Voltworks-Garage/Hardware/README.md

# Hardware
Hardware repo for all PCBA design
