Voltworks-Garage/Hardware/PCBAs/BMS/DischargeCircuit.PNG

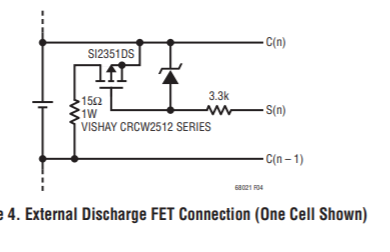
PCBAs/BMS/DischargeCircuit.PNG
