Voltworks-Garage/Hardware/PCBAs/BMS/DischargeCircuit_wRC.PNG

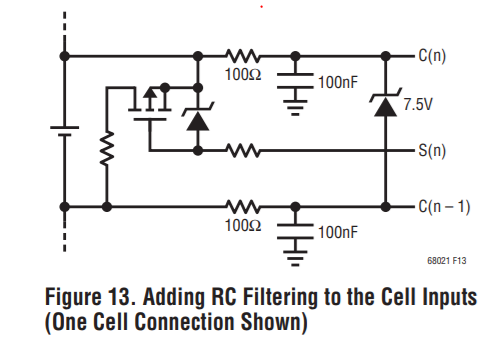
PCBAs/BMS/DischargeCircuit_wRC.PNG
