Voltworks-Garage/Hardware/PCBAs/DCDC/Isolated Gate Drive.PNG

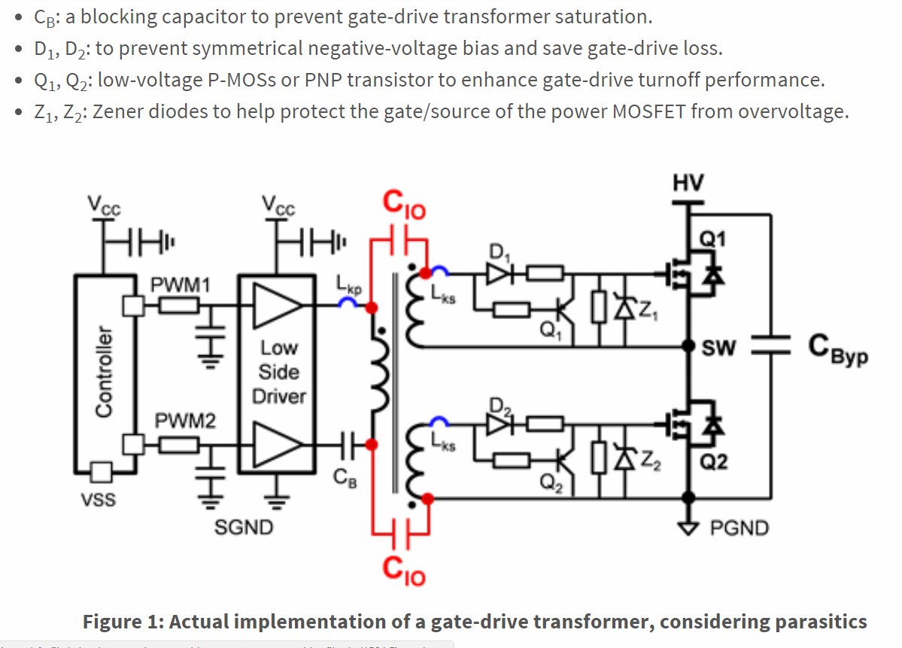
PCBAs/DCDC/Isolated Gate Drive.PNG
