Voltworks-Garage/Hardware/PCBAs/BMS/BMS_02/BOM_by_refdes.xls

RefDes | Value | Digikey_PN | Mouser_PN | MFG_PN | Footprint | Alternate | DNP | Voltage | qty
C1 | 100nF | 490-4779-1-ND |  | GCM188R71H104KA57D | Capacitor_SMD:C_0603_1608Metric |  |  | 50V | 1
C2 | 100nF | 490-4779-1-ND |  | GCM188R71H104KA57D | Capacitor_SMD:C_0603_1608Metric |  |  | 50V | 1
C3 | 100nF | 490-4779-1-ND |  | GCM188R71H104KA57D | Capacitor_SMD:C_0603_1608Metric |  |  | 50V | 1
C4 | 100nF | 490-4779-1-ND |  | GCM188R71H104KA57D | Capacitor_SMD:C_0603_1608Metric |  |  | 50V | 1
C5 | 100nF | 490-4779-1-ND |  | GCM188R71H104KA57D | Capacitor_SMD:C_0603_1608Metric |  |  | 50V | 1
C6 | 100nF | 490-4779-1-ND |  | GCM188R71H104KA57D | Capacitor_SMD:C_0603_1608Metric |  |  | 50V | 1
C7 | 100nF | 490-4779-1-ND |  | GCM188R71H104KA57D | Capacitor_SMD:C_0603_1608Metric |  |  | 50V | 1
C9 | 100nF | 490-4779-1-ND |  | GCM188R71H104KA57D | Capacitor_SMD:C_0603_1608Metric |  |  | 50V | 1
C10 | 18pF | 445-5631-1-ND |  | CGA3E2C0G1H180J080AA | Capacitor_SMD:C_0603_1608Metric |  |  | 50V | 1
C11 | 18pF | 445-5631-1-ND |  | CGA3E2C0G1H180J080AA | Capacitor_SMD:C_0603_1608Metric |  |  | 50V | 1
C14 | 100nF | 490-4779-1-ND |  | GCM188R71H104KA57D | Capacitor_SMD:C_0603_1608Metric |  |  |  | 1
C18 | 100nF | 490-4779-1-ND |  | GCM188R71H104KA57D | Capacitor_SMD:C_0603_1608Metric |  |  |  | 1
C19 | 100nF | 490-4779-1-ND |  | GCM188R71H104KA57D | Capacitor_SMD:C_0603_1608Metric |  |  |  | 1
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
C164 | 100nF | 490-4779-1-ND |  | GCM188R71H104KA57D | Capacitor_SMD:C_0603_1608Metric |  |  |  | 1
C165 | 100nF | 490-4779-1-ND |  | GCM188R71H104KA57D | Capacitor_SMD:C_0603_1608Metric |  |  |  | 1
C166 | 100nF | 490-4779-1-ND |  | GCM188R71H104KA57D | Capacitor_SMD:C_0603_1608Metric |  |  |  | 1
C167 | 100nF | 490-4779-1-ND |  | GCM188R71H104KA57D | Capacitor_SMD:C_0603_1608Metric |  |  |  | 1
C168 | 100nF | 490-4779-1-ND |  | GCM188R71H104KA57D | Capacitor_SMD:C_0603_1608Metric |  |  |  | 1
C169 | 100nF | 490-4779-1-ND |  | GCM188R71H104KA57D | Capacitor_SMD:C_0603_1608Metric |  |  |  | 1
C170 | 100nF | 490-4779-1-ND |  | GCM188R71H104KA57D | Capacitor_SMD:C_0603_1608Metric |  |  |  | 1
C171 | 100nF | 490-4779-1-ND |  | GCM188R71H104KA57D | Capacitor_SMD:C_0603_1608Metric |  |  |  | 1
C172 | 10nF | 490-4781-1-ND |  | GCM188R72A103KA37D | Capacitor_SMD:C_0603_1608Metric |  |  |  | 1
C173 | 10nF | 490-4781-1-ND |  | GCM188R72A103KA37D | Capacitor_SMD:C_0603_1608Metric |  |  |  | 1
C174 | 10nF | 490-4781-1-ND |  | GCM188R72A103KA37D | Capacitor_SMD:C_0603_1608Metric |  |  |  | 1
C175 | 10nF | 490-4781-1-ND |  | GCM188R72A103KA37D | Capacitor_SMD:C_0603_1608Metric |  |  |  | 1
C176 | 10nF | 490-4781-1-ND |  | GCM188R72A103KA37D | Capacitor_SMD:C_0603_1608Metric |  |  |  | 1
C178 | 10nF | 490-4781-1-ND |  | GCM188R72A103KA37D | Capacitor_SMD:C_0603_1608Metric |  |  |  | 1
C8 | 10uF | 1276-6797-1-ND |  | CL31B106KOHVPNE | Capacitor_SMD:C_1206_3216Metric |  |  | 50V | 1
C12 | 100nF | 445-5851-1-ND |  | CGA5L3X7R2E104K160AA | Capacitor_SMD:C_1206_3216Metric |  |  |  | 1
C13 | 100nF | 445-5851-1-ND |  | CGA5L3X7R2E104K160AA | Capacitor_SMD:C_1206_3216Metric |  |  |  | 1
C15 | 100nF | 445-5851-1-ND |  | CGA5L3X7R2E104K160AA | Capacitor_SMD:C_1206_3216Metric |  |  |  | 1
C16 | 100nF | 445-5851-1-ND |  | CGA5L3X7R2E104K160AA | Capacitor_SMD:C_1206_3216Metric |  |  |  | 1
C17 | 100nF | 445-5851-1-ND |  | CGA5L3X7R2E104K160AA | Capacitor_SMD:C_1206_3216Metric |  |  |  | 1
C22 | 10uF | 1276-6797-1-ND |  | CL31B106KOHVPNE | Capacitor_SMD:C_1206_3216Metric |  |  |  | 1
C23 | 10uF | 1276-6797-1-ND |  | CL31B106KOHVPNE | Capacitor_SMD:C_1206_3216Metric |  |  |  | 1
C26 | 100nF | 445-5851-1-ND |  | CGA5L3X7R2E104K160AA | Capacitor_SMD:C_1206_3216Metric |  |  |  | 1
C43 | 100nF | 445-5851-1-ND |  | CGA5L3X7R2E104K160AA | Capacitor_SMD:C_1206_3216Metric |  |  |  | 1
C62 | 4u7 | 445-172481-1-ND |  | CGA5L3X7R1H475K160AE | Capacitor_SMD:C_1206_3216Metric |  |  |  | 1
C66 | 4u7 | 445-172481-1-ND |  | CGA5L3X7R1H475K160AE | Capacitor_SMD:C_1206_3216Metric |  |  |  | 1
C105 | 10uF | 1276-6797-1-ND |  | CL31B106KOHVPNE | Capacitor_SMD:C_1206_3216Metric |  |  |  | 1
C177 | 4u7 | 445-172481-1-ND |  | CGA5L3X7R1H475K160AE | Capacitor_SMD:C_1206_3216Metric |  |  |  | 1
C118 | 1u | 445-4532-1-ND |  |  | Capacitor_SMD:C_2220_5650Metric |  |  |  | 1
C122 | 1u | 445-4532-1-ND |  |  | Capacitor_SMD:C_2220_5650Metric |  |  |  | 1
C133 | 47u | 1189-16SLV47M6.3X6.1CT-ND |  |  | Capacitor_SMD:CP_Elec_6.3x5.9 |  |  |  | 1
C117 | 22u | 493-14364-ND |  |  | Capacitor_THT:CP_Radial_D10.0mm_P5.00mm |  |  |  | 1
J12 | Conn_01x02 |  |  |  | Connector_JST:JST_XH_B2B-XH-A_1x02_P2.50mm_Vertical |  |  |  | 1
J15 | Conn_01x02 |  |  |  | Connector_JST:JST_XH_B2B-XH-A_1x02_P2.50mm_Vertical |  |  |  | 1
J16 | Conn_01x02 |  |  |  | Connector_JST:JST_XH_B2B-XH-A_1x02_P2.50mm_Vertical |  |  |  | 1
J20 | Conn_01x02 |  |  |  | Connector_JST:JST_XH_B2B-XH-A_1x02_P2.50mm_Vertical |  |  |  | 1
J21 | Conn_01x04 |  |  |  | Connector_JST:JST_XH_B3B-XH-A_1x03_P2.50mm_Vertical |  |  |  | 1
J9 | Conn_01x04 |  |  |  | Connector_JST:JST_XH_B4B-XH-A_1x04_P2.50mm_Vertical |  |  |  | 1
J11 | Conn_01x04 |  |  |  | Connector_JST:JST_XH_B4B-XH-A_1x04_P2.50mm_Vertical |  |  |  | 1
J2 | Conn_01x06 |  |  |  | Connector_JST:JST_XH_B6B-XH-A_1x06_P2.50mm_Vertical |  |  |  | 1
J3 | Conn_01x06 |  |  |  | Connector_JST:JST_XH_B6B-XH-A_1x06_P2.50mm_Vertical |  |  |  | 1
J4 | Conn_01x06 |  |  |  | Connector_JST:JST_XH_B6B-XH-A_1x06_P2.50mm_Vertical |  |  |  | 1
J13 | Conn_01x06 |  |  |  | Connector_JST:JST_XH_B6B-XH-A_1x06_P2.50mm_Vertical |  |  |  | 1
J1 | Conn_01x07 |  |  |  | Connector_JST:JST_XH_B7B-XH-A_1x07_P2.50mm_Vertical |  |  |  | 1
J5 | Conn_02x06_Odd_Even |  |  |  | Connector_PinHeader_2.54mm:PinHeader_2x06_P2.54mm_Vertical |  |  |  | 1
J6 | Conn_02x06_Odd_Even |  |  |  | Connector_PinHeader_2.54mm:PinHeader_2x06_P2.54mm_Vertical |  |  |  | 1
J7 | Conn_02x06_Odd_Even |  |  |  | Connector_PinHeader_2.54mm:PinHeader_2x06_P2.54mm_Vertical |  |  |  | 1
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
D78 | 12V | MM3Z12VCCT-ND |  | MM3Z12VC | Diode_SMD:D_SOD-323F |  |  |  | 1
D81 | 12V | MM3Z12VCCT-ND |  | MM3Z12VC | Diode_SMD:D_SOD-323F |  |  |  | 1
J10 | 7807 | 36-7807-ND |  | 7807 | Footprints:7807 |  |  |  | 1
J17 | 7807 | 36-7807-ND |  | 7807 | Footprints:7807 |  |  |  | 1
J18 | 7807 | 36-7807-ND |  | 7807 | Footprints:7807 |  |  |  | 1
J19 | 7807 | 36-7807-ND |  | 7807 | Footprints:7807 |  |  |  | 1
L6 | L_Coupled | 495-4597-1-ND |  | B82787C0513H002 | Footprints:ACT45B |  |  |  | 1
D28 | D_Schottky_Dual_CommonAnode_AKK | 1727-5397-1-ND |  | ESDCAN24-2BLY | Footprints:D_SOT-23_ANK |  |  |  | 1
D29 | D_Schottky_Dual_CommonAnode_AKK | 1727-5397-1-ND |  | ESDCAN24-2BLY | Footprints:D_SOT-23_ANK |  |  |  | 1
D85 | D_Schottky_Dual_CommonAnode_AKK | 1727-5397-1-ND |  | ESDCAN24-2BLY | Footprints:D_SOT-23_ANK |  |  |  | 1
D89 | D_Schottky_Dual_CommonAnode_AKK | 1727-5397-1-ND |  | ESDCAN24-2BLY | Footprints:D_SOT-23_ANK |  |  |  | 1
H1 | MountingHole_Pad |  |  |  | Footprints:MountingHole_3.2mm_M3_Pad_Via |  |  |  | 1
H2 | MountingHole_Pad |  |  |  | Footprints:MountingHole_3.2mm_M3_Pad_Via |  |  |  | 1
H3 | MountingHole_Pad |  |  |  | Footprints:MountingHole_3.2mm_M3_Pad_Via |  |  |  | 1
H4 | MountingHole_Pad |  |  |  | Footprints:MountingHole_3.2mm_M3_Pad_Via |  |  |  | 1
H5 | MountingHole_Pad |  |  |  | Footprints:MountingHole_3.2mm_M3_Pad_Via |  |  |  | 1
NT1 | Net-Tie_2 |  |  |  | Footprints:Net_Tie-0.5mm |  |  |  | 1
Q55 | TPH3300CNH |  | TPH3300CNH | TPH3300CNHL1QCT-ND | L1Q | Footprints:POWER_SO8 |  | L1Q
Q56 | TPH3300CNH |  | TPH3300CNH | TPH3300CNHL1QCT-ND | L1Q | Footprints:POWER_SO8 |  | L1Q
R21 | 15R0 | 2019-WK73R2ATTD15R0FCT-ND |  | WK73R2ATTD15R0F | Footprints:Resistor_SMD_0805_Wide |  |  |  | 1
R25 | 15R0 | 2019-WK73R2ATTD15R0FCT-ND |  | WK73R2ATTD15R0F | Footprints:Resistor_SMD_0805_Wide |  |  |  | 1
R29 | 15R0 | 2019-WK73R2ATTD15R0FCT-ND |  | WK73R2ATTD15R0F | Footprints:Resistor_SMD_0805_Wide |  |  |  | 1
R33 | 15R0 | 2019-WK73R2ATTD15R0FCT-ND |  | WK73R2ATTD15R0F | Footprints:Resistor_SMD_0805_Wide |  |  |  | 1
R37 | 15R0 | 2019-WK73R2ATTD15R0FCT-ND |  | WK73R2ATTD15R0F | Footprints:Resistor_SMD_0805_Wide |  |  |  | 1
R41 | 15R0 | 2019-WK73R2ATTD15R0FCT-ND |  | WK73R2ATTD15R0F | Footprints:Resistor_SMD_0805_Wide |  |  |  | 1
R45 | 15R0 | 2019-WK73R2ATTD15R0FCT-ND |  | WK73R2ATTD15R0F | Footprints:Resistor_SMD_0805_Wide |  |  |  | 1
R49 | 15R0 | 2019-WK73R2ATTD15R0FCT-ND |  | WK73R2ATTD15R0F | Footprints:Resistor_SMD_0805_Wide |  |  |  | 1
R53 | 15R0 | 2019-WK73R2ATTD15R0FCT-ND |  | WK73R2ATTD15R0F | Footprints:Resistor_SMD_0805_Wide |  |  |  | 1
R57 | 15R0 | 2019-WK73R2ATTD15R0FCT-ND |  | WK73R2ATTD15R0F | Footprints:Resistor_SMD_0805_Wide |  |  |  | 1
R61 | 15R0 | 2019-WK73R2ATTD15R0FCT-ND |  | WK73R2ATTD15R0F | Footprints:Resistor_SMD_0805_Wide |  |  |  | 1
R65 | 15R0 | 2019-WK73R2ATTD15R0FCT-ND |  | WK73R2ATTD15R0F | Footprints:Resistor_SMD_0805_Wide |  |  |  | 1
R81 | 15R0 | 2019-WK73R2ATTD15R0FCT-ND |  | WK73R2ATTD15R0F | Footprints:Resistor_SMD_0805_Wide |  |  |  | 1
R85 | 15R0 | 2019-WK73R2ATTD15R0FCT-ND |  | WK73R2ATTD15R0F | Footprints:Resistor_SMD_0805_Wide |  |  |  | 1
R89 | 15R0 | 2019-WK73R2ATTD15R0FCT-ND |  | WK73R2ATTD15R0F | Footprints:Resistor_SMD_0805_Wide |  |  |  | 1
R93 | 15R0 | 2019-WK73R2ATTD15R0FCT-ND |  | WK73R2ATTD15R0F | Footprints:Resistor_SMD_0805_Wide |  |  |  | 1
R97 | 15R0 | 2019-WK73R2ATTD15R0FCT-ND |  | WK73R2ATTD15R0F | Footprints:Resistor_SMD_0805_Wide |  |  |  | 1
R101 | 15R0 | 2019-WK73R2ATTD15R0FCT-ND |  | WK73R2ATTD15R0F | Footprints:Resistor_SMD_0805_Wide |  |  |  | 1
R105 | 15R0 | 2019-WK73R2ATTD15R0FCT-ND |  | WK73R2ATTD15R0F | Footprints:Resistor_SMD_0805_Wide |  |  |  | 1
R109 | 15R0 | 2019-WK73R2ATTD15R0FCT-ND |  | WK73R2ATTD15R0F | Footprints:Resistor_SMD_0805_Wide |  |  |  | 1
R113 | 15R0 | 2019-WK73R2ATTD15R0FCT-ND |  | WK73R2ATTD15R0F | Footprints:Resistor_SMD_0805_Wide |  |  |  | 1
R117 | 15R0 | 2019-WK73R2ATTD15R0FCT-ND |  | WK73R2ATTD15R0F | Footprints:Resistor_SMD_0805_Wide |  |  |  | 1
R121 | 15R0 | 2019-WK73R2ATTD15R0FCT-ND |  | WK73R2ATTD15R0F | Footprints:Resistor_SMD_0805_Wide |  |  |  | 1
R125 | 15R0 | 2019-WK73R2ATTD15R0FCT-ND |  | WK73R2ATTD15R0F | Footprints:Resistor_SMD_0805_Wide |  |  |  | 1
L1 | L_Ferrite | 732-1591-1-ND |  | 742792609 | Inductor_SMD:L_0603_1608Metric |  |  |  | 1
L2 | L_Ferrite | 732-1591-1-ND |  | 742792609 | Inductor_SMD:L_0603_1608Metric |  |  |  | 1
L4 | L_Ferrite | 732-1591-1-ND |  | 742792609 | Inductor_SMD:L_0603_1608Metric |  |  |  | 1
L5 | L_Ferrite | 732-1591-1-ND |  | 742792609 | Inductor_SMD:L_0603_1608Metric |  |  |  | 1
L8 | L_Ferrite | 732-1591-1-ND |  | 742792609 | Inductor_SMD:L_0603_1608Metric |  |  |  | 1
L9 | L_Ferrite | 732-1591-1-ND |  | 742792609 | Inductor_SMD:L_0603_1608Metric |  |  |  | 1
L10 | L_Ferrite | 732-1591-1-ND |  | 742792609 | Inductor_SMD:L_0603_1608Metric |  |  |  | 1
L3 | 47u | 587-2104-1-ND |  | NR6028T470M | Inductors:Inductor_Taiyo-Yuden_NR-60xx |  |  |  | 1
U1 | PIC33EP256MC506 |  | 579-33EP64GP506IPT |  | Package_QFP:TQFP-64_10x10mm_P0.5mm |  |  |  | 1
U4 | LTC3638 |  |  |  | Package_SO:Linear_MSOP-12-16-1EP_3x4mm_P0.5mm |  |  |  | 1
U18 | LTC7001 |  |  |  | Package_SO:MSOP-10-1EP_3x3mm_P0.5mm_EP1.68x1.88mm_ThermalVias |  |  |  | 1
U22 | LTC7001 |  |  |  | Package_SO:MSOP-10-1EP_3x3mm_P0.5mm_EP1.68x1.88mm_ThermalVias |  |  |  | 1
U12 | TLX9185A(GBTPL |  |  | 264-TLX9185A(GBTPLFCT-ND | F | Package_SO:SO-4_4.4x3.9mm_P2.54mm
U15 | TLX9185A(GBTPL |  |  | 264-TLX9185A(GBTPLFCT-ND | F | Package_SO:SO-4_4.4x3.9mm_P2.54mm
U16 | TLX9185A(GBTPL |  |  | 264-TLX9185A(GBTPLFCT-ND | F | Package_SO:SO-4_4.4x3.9mm_P2.54mm
U2 | LM2931-5.0_SO8 | 296-11120-5-ND |  |  | Package_SO:SOIC-8_3.9x4.9mm_P1.27mm |  |  |  | 1
U8 | MCP2562-E-SN | 296-SN65HVDA1040BQDRQ1CT-ND |  |  | Package_SO:SOIC-8_3.9x4.9mm_P1.27mm |  |  |  | 1
U13 | ADUM1281ARZ-RL7 | ADUM1281ARZ-RL7CT-ND |  |  | Package_SO:SOIC-8_3.9x4.9mm_P1.27mm |  |  |  | 1
U14 | ADUM1281ARZ-RL7 | ADUM1281ARZ-RL7CT-ND |  |  | Package_SO:SOIC-8_3.9x4.9mm_P1.27mm |  |  |  | 1
U20 | CT415-HSN820DR |  | 462-CT415-HSN820DR |  | Package_SO:SOIC-8_3.9x4.9mm_P1.27mm |  |  |  | 1
U21 | LMV393 | LMV393MX/NOPBCT-ND |  |  | Package_SO:SOIC-8_3.9x4.9mm_P1.27mm |  |  |  | 1
U27 | FAN3216TMX-F085 | FAN3216TMX-F085CT-ND |  |  | Package_SO:SOIC-8_3.9x4.9mm_P1.27mm |  |  |  | 1
U7 | FT231XS |  |  |  | Package_SO:SSOP-20_3.9x8.7mm_P0.635mm |  |  |  | 1
U6 | LTC6802-1 |  |  |  | Package_SO:SSOP-44_5.3x12.8mm_P0.5mm |  |  |  | 1
U11 | LTC6802-1 |  |  |  | Package_SO:SSOP-44_5.3x12.8mm_P0.5mm |  |  |  | 1
U5 | CD4051B | 296-49580-1-ND |  | CD4051BQPWRG4Q1 | Package_SO:TSSOP-16_4.4x5mm_P0.65mm |  |  |  | 1
U17 | CD4051B | 296-49580-1-ND |  | CD4051BQPWRG4Q1 | Package_SO:TSSOP-16_4.4x5mm_P0.65mm |  |  |  | 1
U26 | CD4051B | 296-49580-1-ND |  | CD4051BQPWRG4Q1 | Package_SO:TSSOP-16_4.4x5mm_P0.65mm |  |  |  | 1
Q58 | RQ3G100GNTB | RQ3G100GNTBCT-ND |  | RQ3G100GNTB | Package_TO_SOT_SMD:LFPAK33 |  |  |  | 1
Q59 | RQ3G100GNTB | RQ3G100GNTBCT-ND |  | RQ3G100GNTB | Package_TO_SOT_SMD:LFPAK33 |  |  |  | 1
Q1 | Q_NMOS_GSD | TN5335K1-GCT-ND |  | TN5335K1-G | Package_TO_SOT_SMD:SOT-23 |  |  |  | 1
Q2 | Q_NMOS_GSD | TN5335K1-GCT-ND |  | TN5335K1-G | Package_TO_SOT_SMD:SOT-23 |  |  |  | 1
Q3 | Q_PMOS_GSD | TP5335K1-GCT-ND |  | TP5335K1-G | Package_TO_SOT_SMD:SOT-23 |  |  |  | 1
Q4 | Q_PMOS_GSD | 1801-TSM2301ACXRFGCT-ND |  | SI2301S-2.3A | Package_TO_SOT_SMD:SOT-23 |  |  |  | 1
Q5 | Q_PMOS_GSD | 1801-TSM2301ACXRFGCT-ND |  | SI2301S-2.3A | Package_TO_SOT_SMD:SOT-23 |  |  |  | 1
Q6 | Q_PMOS_GSD | 1801-TSM2301ACXRFGCT-ND |  | SI2301S-2.3A | Package_TO_SOT_SMD:SOT-23 |  |  |  | 1
Q7 | Q_PMOS_GSD | 1801-TSM2301ACXRFGCT-ND |  | SI2301S-2.3A | Package_TO_SOT_SMD:SOT-23 |  |  |  | 1
Q8 | Q_PMOS_GSD | 1801-TSM2301ACXRFGCT-ND |  | SI2301S-2.3A | Package_TO_SOT_SMD:SOT-23 |  |  |  | 1
Q9 | Q_PMOS_GSD | 1801-TSM2301ACXRFGCT-ND |  | SI2301S-2.3A | Package_TO_SOT_SMD:SOT-23 |  |  |  | 1
Q10 | Q_PMOS_GSD | 1801-TSM2301ACXRFGCT-ND |  | SI2301S-2.3A | Package_TO_SOT_SMD:SOT-23 |  |  |  | 1
Q11 | Q_PMOS_GSD | 1801-TSM2301ACXRFGCT-ND |  | SI2301S-2.3A | Package_TO_SOT_SMD:SOT-23 |  |  |  | 1
Q12 | Q_PMOS_GSD | 1801-TSM2301ACXRFGCT-ND |  | SI2301S-2.3A | Package_TO_SOT_SMD:SOT-23 |  |  |  | 1
Q13 | Q_PMOS_GSD | 1801-TSM2301ACXRFGCT-ND |  | SI2301S-2.3A | Package_TO_SOT_SMD:SOT-23 |  |  |  | 1
Q14 | Q_PMOS_GSD | 1801-TSM2301ACXRFGCT-ND |  | SI2301S-2.3A | Package_TO_SOT_SMD:SOT-23 |  |  |  | 1
Q15 | Q_PMOS_GSD | 1801-TSM2301ACXRFGCT-ND |  | SI2301S-2.3A | Package_TO_SOT_SMD:SOT-23 |  |  |  | 1
Q16 | Q_NMOS_GSD | TN5335K1-GCT-ND |  | TN5335K1-G | Package_TO_SOT_SMD:SOT-23 |  |  |  | 1
Q17 | Q_NMOS_GSD | TN5335K1-GCT-ND |  | TN5335K1-G | Package_TO_SOT_SMD:SOT-23 |  |  |  | 1
Q18 | Q_PMOS_GSD | TP5335K1-GCT-ND |  | TP5335K1-G | Package_TO_SOT_SMD:SOT-23 |  |  |  | 1
Q19 | Q_PMOS_GSD | 1801-TSM2301ACXRFGCT-ND |  | SI2301S-2.3A | Package_TO_SOT_SMD:SOT-23 |  |  |  | 1
Q20 | Q_PMOS_GSD | 1801-TSM2301ACXRFGCT-ND |  | SI2301S-2.3A | Package_TO_SOT_SMD:SOT-23 |  |  |  | 1
Q21 | Q_PMOS_GSD | 1801-TSM2301ACXRFGCT-ND |  | SI2301S-2.3A | Package_TO_SOT_SMD:SOT-23 |  |  |  | 1
Q22 | Q_PMOS_GSD | 1801-TSM2301ACXRFGCT-ND |  | SI2301S-2.3A | Package_TO_SOT_SMD:SOT-23 |  |  |  | 1
Q23 | Q_PMOS_GSD | 1801-TSM2301ACXRFGCT-ND |  | SI2301S-2.3A | Package_TO_SOT_SMD:SOT-23 |  |  |  | 1
Q24 | Q_PMOS_GSD | 1801-TSM2301ACXRFGCT-ND |  | SI2301S-2.3A | Package_TO_SOT_SMD:SOT-23 |  |  |  | 1
Q25 | Q_PMOS_GSD | 1801-TSM2301ACXRFGCT-ND |  | SI2301S-2.3A | Package_TO_SOT_SMD:SOT-23 |  |  |  | 1
Q26 | Q_PMOS_GSD | 1801-TSM2301ACXRFGCT-ND |  | SI2301S-2.3A | Package_TO_SOT_SMD:SOT-23 |  |  |  | 1
Q27 | Q_PMOS_GSD | 1801-TSM2301ACXRFGCT-ND |  | SI2301S-2.3A | Package_TO_SOT_SMD:SOT-23 |  |  |  | 1
Q28 | Q_PMOS_GSD | 1801-TSM2301ACXRFGCT-ND |  | SI2301S-2.3A | Package_TO_SOT_SMD:SOT-23 |  |  |  | 1
Q29 | Q_PMOS_GSD | 1801-TSM2301ACXRFGCT-ND |  | SI2301S-2.3A | Package_TO_SOT_SMD:SOT-23 |  |  |  | 1
Q30 | Q_PMOS_GSD | 1801-TSM2301ACXRFGCT-ND |  | SI2301S-2.3A | Package_TO_SOT_SMD:SOT-23 |  |  |  | 1
Q31 | Q_PMOS_GSD | TP5335K1-GCT-ND |  | TP5335K1-G | Package_TO_SOT_SMD:SOT-23 |  |  |  | 1
Q34 | Q_NMOS_GSD | TN5335K1-GCT-ND |  | TN5335K1-G | Package_TO_SOT_SMD:SOT-23 |  |  |  | 1
U3 | TPS73633DBV | 296-TLV73330PQDBVRQ1CT-ND |  |  | Package_TO_SOT_SMD:SOT-23-5 | TLV733P-Q1 |  |  | 1
U10 | OPA320-Q1 | 296-47595-1-ND |  |  | Package_TO_SOT_SMD:SOT-23-5 |  |  |  | 1
U23 | OPA320-Q1 | 296-47595-1-ND |  |  | Package_TO_SOT_SMD:SOT-23-5 |  |  |  | 1
U9 | TPS2551-Q1 | 31-AP22652AW6-7CT-ND |  |  | Package_TO_SOT_SMD:SOT-23-6 | AP22652W6-7 |  |  | 1
U24 | INA181 | 296-46635-1-ND |  |  | Package_TO_SOT_SMD:SOT-23-6 |  |  |  | 1
U25 | INA181 | 296-INA181A3QDBVRQ1CT-ND |  |  | Package_TO_SOT_SMD:SOT-23-6 |  |  |  | 1
Q32 | Q_DUAL_NMOS_PMOS | US6M2CT-ND |  | US6M2TR | Package_TO_SOT_SMD:SOT-363_SC-70-6 |  |  |  | 1
Q33 | Q_DUAL_NMOS_PMOS | US6M2CT-ND |  | US6M2TR | Package_TO_SOT_SMD:SOT-363_SC-70-6 |  |  |  | 1
Q44 | Q_DUAL_NMOS_PMOS | US6M2CT-ND |  | US6M2TR | Package_TO_SOT_SMD:SOT-363_SC-70-6 |  |  |  | 1
Q54 | Q_DUAL_NMOS_PMOS | US6M2CT-ND |  | US6M2TR | Package_TO_SOT_SMD:SOT-363_SC-70-6 |  |  |  | 1
Q35 | Q_PMOS_GDS | FQB12P20TMCT-ND |  | FQB12P20TM | Package_TO_SOT_SMD:TO-263-2 |  |  |  | 1
Q42 | NTB5D0N15MC |  | 863-NTB5D0N15MC | NTB5D0N15MC | Package_TO_SOT_SMD:TO-263-2 |  |  |  | 1
Q43 | NTB5D0N15MC |  | 863-NTB5D0N15MC | NTB5D0N15MC | Package_TO_SOT_SMD:TO-263-2 |  |  |  | 1
Q45 | NTB5D0N15MC |  | 863-NTB5D0N15MC | NTB5D0N15MC | Package_TO_SOT_SMD:TO-263-2 |  |  |  | 1
Q46 | NTB5D0N15MC |  | 863-NTB5D0N15MC | NTB5D0N15MC | Package_TO_SOT_SMD:TO-263-2 |  |  |  | 1
Q47 | NTB5D0N15MC |  | 863-NTB5D0N15MC | NTB5D0N15MC | Package_TO_SOT_SMD:TO-263-2 |  |  |  | 1
Q48 | NTB5D0N15MC |  | 863-NTB5D0N15MC | NTB5D0N15MC | Package_TO_SOT_SMD:TO-263-2 |  |  |  | 1
Q49 | NTB5D0N15MC |  | 863-NTB5D0N15MC | NTB5D0N15MC | Package_TO_SOT_SMD:TO-263-2 |  |  |  | 1
Q50 | NTB5D0N15MC |  | 863-NTB5D0N15MC | NTB5D0N15MC | Package_TO_SOT_SMD:TO-263-2 |  |  |  | 1
R1 | 10k0 | 311-10KLDCT-ND |  | AC0603FR-0710KL | Resistor_SMD:R_0603_1608Metric |  |  |  | 1
R2 | 10k0 | 311-10KLDCT-ND |  | AC0603FR-0710KL | Resistor_SMD:R_0603_1608Metric |  |  |  | 1
R3 | 1M | 311-1MLDCT-ND |  | AC0603FR-071ML | Resistor_SMD:R_0603_1608Metric |  |  |  | 1
R4 | 1M | 311-1MLDCT-ND |  | AC0603FR-071ML | Resistor_SMD:R_0603_1608Metric |  | < ... > |  | 1
R5 | 32k0 | 2019-RN73R1JTTD3202B25CT-ND |  | RN73R1JTTD3202B25 | Resistor_SMD:R_0603_1608Metric |  |  |  | 1
R6 | 13k0 | RMCF0603FT13K0CT-ND |  | RMCF0603FT13K0 | Resistor_SMD:R_0603_1608Metric |  |  |  | 1
R7 | 100R | YAG3561CT-ND |  | AC0603FR-07100RL | Resistor_SMD:R_0603_1608Metric |  |  |  | 1
R8 | 3R3 | RHM303DCT-ND |  | ESR03EZPJ3R3 | Resistor_SMD:R_0603_1608Metric |  |  |  | 1
R9 | 20R0 | RMCF0603FT20R0CT-ND |  | RMCF0603FT20R0 | Resistor_SMD:R_0603_1608Metric |  |  |  | 1
R10 | 10k0 | 311-10KLDCT-ND |  | AC0603FR-0710KL | Resistor_SMD:R_0603_1608Metric |  | < ... > |  | 1
R11 | 19k6 | RMCF0603FT19K6CT-ND |  | RMCF0603FT19K6 | Resistor_SMD:R_0603_1608Metric |  |  |  | 1
R12 | 10k0 | 311-10KLDCT-ND |  | AC0603FR-0710KL | Resistor_SMD:R_0603_1608Metric |  | < ... > |  | 1
R13 | 10k0 | 311-10KLDCT-ND |  | AC0603FR-0710KL | Resistor_SMD:R_0603_1608Metric |  | < ... > |  | 1
R14 | 1M | 311-1MLDCT-ND |  | AC0603FR-071ML | Resistor_SMD:R_0603_1608Metric |  | < ... > |  | 1
R15 | 10k0 | 311-10KLDCT-ND |  | AC0603FR-0710KL | Resistor_SMD:R_0603_1608Metric |  | < ... > |  | 1
R16 | 32k0 | 2019-RN73R1JTTD3202B25CT-ND |  | RN73R1JTTD3202B25 | Resistor_SMD:R_0603_1608Metric |  |  |  | 1
R17 | 100k | RMCF0603FT100KCT-ND |  | RMCF0603FT100K | Resistor_SMD:R_0603_1608Metric |  |  |  | 1
R18 | 499k | RMCF0603FT499KCT-ND |  | RMCF0603FT499K | Resistor_SMD:R_0603_1608Metric |  |  |  | 1
R19 | 26k1 0.1% | A140602CT-ND |  |  | Resistor_SMD:R_0603_1608Metric |  |  |  | 1
R20 | 1M | 311-1MLDCT-ND |  | AC0603FR-071ML | Resistor_SMD:R_0603_1608Metric |  | < ... > |  | 1
R22 | 1k8 | RMCF0603JG1K80CT-ND |  | RMCF0603JG1K80 | Resistor_SMD:R_0603_1608Metric |  |  |  | 1
R23 | 100R | YAG3561CT-ND |  | AC0603FR-07100RL | Resistor_SMD:R_0603_1608Metric |  |  |  | 1
R24 | 3k3 | RMCF0603JT3K30CT-ND |  | RMCF0603JT3K30 | Resistor_SMD:R_0603_1608Metric |  |  |  | 1
R26 | 4k7 |  |  | ~ | Resistor_SMD:R_0603_1608Metric |  |  |  | 1
R27 | 100R | YAG3561CT-ND |  | AC0603FR-07100RL | Resistor_SMD:R_0603_1608Metric |  |  |  | 1
R28 | 3k3 | RMCF0603JT3K30CT-ND |  | RMCF0603JT3K30 | Resistor_SMD:R_0603_1608Metric |  |  |  | 1
R30 | 100R | YAG3561CT-ND |  | AC0603FR-07100RL | Resistor_SMD:R_0603_1608Metric |  |  |  | 1
R31 | 100R | YAG3561CT-ND |  | AC0603FR-07100RL | Resistor_SMD:R_0603_1608Metric |  |  |  | 1
R32 | 3k3 | RMCF0603JT3K30CT-ND |  | RMCF0603JT3K30 | Resistor_SMD:R_0603_1608Metric |  |  |  | 1
R34 | 10k0 | 311-10KLDCT-ND |  | AC0603FR-0710KL | Resistor_SMD:R_0603_1608Metric |  |  |  | 1
R35 | 100R | YAG3561CT-ND |  | AC0603FR-07100RL | Resistor_SMD:R_0603_1608Metric |  |  |  | 1
R36 | 3k3 | RMCF0603JT3K30CT-ND |  | RMCF0603JT3K30 | Resistor_SMD:R_0603_1608Metric |  |  |  | 1
R38 | 100k | RMCF0603FT100KCT-ND |  | RMCF0603FT100K | Resistor_SMD:R_0603_1608Metric |  |  |  | 1
R39 | 100R | YAG3561CT-ND |  | AC0603FR-07100RL | Resistor_SMD:R_0603_1608Metric |  |  |  | 1
R40 | 3k3 | RMCF0603JT3K30CT-ND |  | RMCF0603JT3K30 | Resistor_SMD:R_0603_1608Metric |  |  |  | 1
R42 | 100k | RMCF0603FT100KCT-ND |  | RMCF0603FT100K | Resistor_SMD:R_0603_1608Metric |  |  |  | 1
R43 | 100R | YAG3561CT-ND |  | AC0603FR-07100RL | Resistor_SMD:R_0603_1608Metric |  |  |  | 1
R44 | 3k3 | RMCF0603JT3K30CT-ND |  | RMCF0603JT3K30 | Resistor_SMD:R_0603_1608Metric |  |  |  | 1
R46 | 100k | RMCF0603FT100KCT-ND |  | RMCF0603FT100K | Resistor_SMD:R_0603_1608Metric |  |  |  | 1
R47 | 100R | YAG3561CT-ND |  | AC0603FR-07100RL | Resistor_SMD:R_0603_1608Metric |  |  |  | 1
R48 | 3k3 | RMCF0603JT3K30CT-ND |  | RMCF0603JT3K30 | Resistor_SMD:R_0603_1608Metric |  |  |  | 1
R51 | 100R | YAG3561CT-ND |  | AC0603FR-07100RL | Resistor_SMD:R_0603_1608Metric |  |  |  | 1
R52 | 3k3 | RMCF0603JT3K30CT-ND |  | RMCF0603JT3K30 | Resistor_SMD:R_0603_1608Metric |  |  |  | 1
R54 | 1M | 311-1MLDCT-ND |  | AC0603FR-071ML | Resistor_SMD:R_0603_1608Metric |  | < ... > |  | 1
R55 | 100R | YAG3561CT-ND |  | AC0603FR-07100RL | Resistor_SMD:R_0603_1608Metric |  |  |  | 1
R56 | 3k3 | RMCF0603JT3K30CT-ND |  | RMCF0603JT3K30 | Resistor_SMD:R_0603_1608Metric |  |  |  | 1
R58 | 1M | 311-1MLDCT-ND |  | AC0603FR-071ML | Resistor_SMD:R_0603_1608Metric |  | < ... > |  | 1
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
R250 | 3R3 | RHM303DCT-ND |  | ESR03EZPJ3R3 | Resistor_SMD:R_0603_1608Metric |  |  |  | 1
R251 | 3R3 | RHM303DCT-ND |  | ESR03EZPJ3R3 | Resistor_SMD:R_0603_1608Metric |  |  |  | 1
R252 | 19k6 | RMCF0603FT19K6CT-ND |  | RMCF0603FT19K6 | Resistor_SMD:R_0603_1608Metric |  |  |  | 1
R253 | 10k0 | 311-10KLDCT-ND |  | AC0603FR-0710KL | Resistor_SMD:R_0603_1608Metric |  |  |  | 1
R254 | 10k0 | 311-10KLDCT-ND |  | AC0603FR-0710KL | Resistor_SMD:R_0603_1608Metric |  |  |  | 1
R255 | 10k0 | 311-10KLDCT-ND |  | AC0603FR-0710KL | Resistor_SMD:R_0603_1608Metric |  | < ... > |  | 1
R256 | 19k6 | RMCF0603FT19K6CT-ND |  | RMCF0603FT19K6 | Resistor_SMD:R_0603_1608Metric |  |  |  | 1
R257 | 100k | RMCF0603FT100KCT-ND |  | RMCF0603FT100K | Resistor_SMD:R_0603_1608Metric |  |  |  | 1
R258 | 10M | RMCF0603FT10M0CT-ND |  | RMCF0603FT10M0 | Resistor_SMD:R_0603_1608Metric |  |  |  | 1
R259 | 10M | RMCF0603FT10M0CT-ND |  | RMCF0603FT10M0 | Resistor_SMD:R_0603_1608Metric |  |  |  | 1
R260 | 10M | RMCF0603FT10M0CT-ND |  | RMCF0603FT10M0 | Resistor_SMD:R_0603_1608Metric |  |  |  | 1
R261 | 10M | RMCF0603FT10M0CT-ND |  | RMCF0603FT10M0 | Resistor_SMD:R_0603_1608Metric |  |  |  | 1
R262 | 10M | RMCF0603FT10M0CT-ND |  | RMCF0603FT10M0 | Resistor_SMD:R_0603_1608Metric |  |  |  | 1
R263 | 10M | RMCF0603FT10M0CT-ND |  | RMCF0603FT10M0 | Resistor_SMD:R_0603_1608Metric |  |  |  | 1
R264 | 1M | 311-1MLDCT-ND |  | AC0603FR-071ML | Resistor_SMD:R_0603_1608Metric |  |  |  | 1
R267 | 10k0 | 311-10KLDCT-ND |  | AC0603FR-0710KL | Resistor_SMD:R_0603_1608Metric |  | < ... > |  | 1
R270 | 1M | 311-1MLDCT-ND |  | AC0603FR-071ML | Resistor_SMD:R_0603_1608Metric |  | < ... > |  | 1
R271 | 1M | 311-1MLDCT-ND |  | AC0603FR-071ML | Resistor_SMD:R_0603_1608Metric |  | < ... > |  | 1
R272 | 1M | 311-1MLDCT-ND |  | AC0603FR-071ML | Resistor_SMD:R_0603_1608Metric |  | < ... > |  | 1
R273 | 100k | RMCF0603FT100KCT-ND |  | RMCF0603FT100K | Resistor_SMD:R_0603_1608Metric |  |  |  | 1
R274 | 10k0 | 311-10KLDCT-ND |  | AC0603FR-0710KL | Resistor_SMD:R_0603_1608Metric |  |  |  | 1
R275 | 1M | 311-1MLDCT-ND |  | AC0603FR-071ML | Resistor_SMD:R_0603_1608Metric |  | < ... > |  | 1
R276 | 1M | 311-1MLDCT-ND |  | AC0603FR-071ML | Resistor_SMD:R_0603_1608Metric |  | < ... > |  | 1
R277 | 1M | 311-1MLDCT-ND |  | AC0603FR-071ML | Resistor_SMD:R_0603_1608Metric |  | < ... > |  | 1
R278 | 100k | RMCF0603FT100KCT-ND |  | RMCF0603FT100K | Resistor_SMD:R_0603_1608Metric |  |  |  | 1
R279 | 10k0 | 311-10KLDCT-ND |  | AC0603FR-0710KL | Resistor_SMD:R_0603_1608Metric |  | < ... > |  | 1
R280 | 10k0 | 311-10KLDCT-ND |  | AC0603FR-0710KL | Resistor_SMD:R_0603_1608Metric |  | < ... > |  | 1
R282 | 10k0 | 311-10KLDCT-ND |  | AC0603FR-0710KL | Resistor_SMD:R_0603_1608Metric |  | < ... > |  | 1
TH1 | Thermistor_NTC | 495-76084-1-ND |  | B57355V5104F360 | Resistor_SMD:R_0603_1608Metric |  |  |  | 1
TH2 | Thermistor_NTC | 495-76084-1-ND |  | B57355V5104F360 | Resistor_SMD:R_0603_1608Metric |  |  |  | 1
R136 | 60R | RMCF2512JT62R0CT-ND |  | RMCF2512JT62R0 | Resistor_SMD:R_2512_6332Metric |  |  |  | 1
R137 | 60R | RMCF2512JT62R0CT-ND |  | RMCF2512JT62R0 | Resistor_SMD:R_2512_6332Metric |  |  |  | 1
R50 | 100R | 100W-10-ND |  | SQP10AJB-100R | Resistor_THT:R_Axial_Power_L50.0mm_W9.0mm_P55.88mm |  |  |  | 1
U19 | ACS72981LLRATR-100B5 |  | 250-72981LLRATR100B5 |  | Sensor_Current:Allegro_PSOF-7_4.8x6.4mm_P1.60mm |  |  |  | 1
TP1 | TestPoint |  |  |  | TestPoint:TestPoint_Pad_1.0x1.0mm |  |  |  | 1
