Voltworks-Garage/Hardware/PCBAs/BodyController/BodyController_01/Scripts/BOM.xls

MPN | QTY | RefDes
2N7002P,215 | 4 | Q16, Q3, Q8, Q9
AC0603FR-0710KL | 56 | R10, R101, R11, R113, R114, R115, R116, R12, R121, R123, R129, R13, R131, R137, R140, R141, R145, R146, R151, R152, R153, R161, R162, R163, R166, R167, R17, R171, R18, R181, R19, R22, R29, R32, R33, R34, R39, R42, R45, R5, R56, R57, R58, R6, R64, R65, R68, R7, R71, R74, R86, R89, R95, R96, R97, R98
BUK7J1R4-40HX | 2 | Q12, Q13
HCS2512FTL500 | 1 | R16
BTS716GXUMA1 | 2 | U15, U4
BTS50202EKAXUMA2 | 6 | U11, U12, U13, U7, U8, U9
AC0603FR-071ML | 1 | R1
B82787C0513H002 | 1 | L4
AC0603FR-0722RL | 3 | R106, R174, R175
BTS500801TMAATMA1 | 2 | U5, U6
MMSZ5245BT1G | 3 | D21, D23, D8
PMEG060V100EPDZ | 2 | D25, D5
EMHJ350ADA470MF80G | 2 | C24, C30
LM2903QDRQ1 | 2 | U2, U21
SQJ423EP-T1_GE3 | 1 | Q4
DSPIC33EP512MU810-E/PF | 1 | U1
LM2904AVQDRQ1 | 1 | U10
ERJ-3GEYJ3R0V | 11 | R102, R103, R14, R142, R143, R148, R149, R15, R150, R154, R155
ESDCAN24-2BLY | 1 | D10
NX1029X,115 | 5 | Q1, Q10, Q2, Q6, Q7
CGA4J3X7R1H105M125AE | 13 | C110, C16, C17, C18, C20, C21, C70, C76, C77, C78, C79, C80, C81
AC0603FR-07330RL | 2 | R179, R180
PTS645SM43SMTR92 LFS | 1 | SW1
AC0603FR-0749K9L | 1 | R99
HCS2512FTL300 | 1 | R156
BAS170WE6327HTSA1 | 3 | D17, D26, D27
TPS70950QDBVRQ1 | 1 | U17
7796 | 3 | J1, J5, J6
GCM188R71H104KA57D | 12 | C1, C111, C2, C37, C5, C50, C6, C61, C7, C8, C83, C87
CGA3E2X7R1H103K080AA | 72 | C10, C100, C101, C102, C103, C104, C105, C106, C107, C108, C109, C11, C112, C114, C115, C116, C117, C129, C130, C131, C132, C137, C138, C139, C140, C15, C19, C28, C29, C31, C32, C33, C34, C35, C36, C38, C39, C40, C41, C42, C43, C44, C45, C51, C52, C54, C58, C59, C60, C62, C63, C64, C65, C66, C67, C68, C73, C75, C82, C85, C88, C89, C90, C91, C92, C93, C94, C95, C96, C97, C98, C99
CGA3E2C0G1H180J080AA | 7 | C133, C134, C135, C136, C3, C4, C53
AC0603FR-0722KL | 3 | R128, R170, R172
AC0603FR-074K7L | 12 | R105, R160, R35, R36, R4, R48, R51, R54, R63, R77, R80, R83
DFLS1100Q-7 | 6 | D11, D12, D13, D14, D18, D19
BAT54SFILMY | 1 | D16
PMEG6020AELRX | 7 | D1, D2, D24, D3, D6, D7, D9
BSS84AK,215 | 2 | Q17, Q5
RMCF2512JT62R0 | 2 | R93, R94
DRV8872DDARQ1 | 1 | U22
CGA3E2X7R1H102K080AA | 5 | C14, C22, C57, C69, C74
LTST-C191KRKT | 1 | D4
TPS70933QDBVRQ1 | 2 | U18, U19
TPSMC33A | 1 | D15
TPS25940AQRVCRQ1 | 1 | U23
C1206C106M3RACAUTO | 18 | C113, C118, C119, C120, C121, C122, C123, C124, C125, C126, C127, C128, C26, C46, C49, C55, C56, C9
5015 | 8 | TP1, TP2, TP3, TP4, TP5, TP6, TP7, TP8
AC0603FR-072K74L | 1 | R73
ERJ-3EKF3402V | 3 | R104, R127, R3
1051330001 | 1 | J8
RMCF0603FT845K | 1 | R107
AC0603FR-07150KL | 6 | R108, R112, R122, R124, R24, R61
NRS6045T100MMGKV | 1 | L3
FT230XS-R | 1 | U29
LMR14020SQDDARQ1 | 1 | U20
CGA5L3X7R1H475K160AE | 9 | C23, C25, C27, C47, C48, C71, C72, C84, C86
MAL214699004E3 | 2 | C12, C13
TCAN1051GVDRQ1 | 1 | U16
AC0603FR-07100KL | 28 | R100, R111, R117, R118, R119, R120, R126, R130, R132, R133, R134, R135, R136, R139, R144, R147, R159, R164, R165, R168, R169, R178, R25, R26, R59, R60, R8, R9
OPA320AQDBVRQ1 | 1 | U14
RMCF0603FT1K30 | 1 | R176
MPZ1608S300ATDH5 | 2 | L1, L2
AC0603FR-07100RL | 43 | R109, R110, R138, R173, R2, R20, R21, R27, R28, R30, R31, R37, R38, R40, R41, R43, R44, R46, R47, R49, R50, R52, R53, R55, R62, R66, R67, R69, R70, R72, R75, R76, R78, R79, R81, R82, R84, R85, R87, R88, R90, R91, R92
ECS-80-18-20BQ-DS | 1 | Y1
AC0603FR-07560KL | 3 | R125, R177, R23
INA214AQDCKRQ1 | 2 | U27, U3
UCC27511AQDBVRQ1 | 1 | U25
