Voltworks-Garage/Hardware/PCBAs/BMS/Validation/5V_Ripple_200u_inductor.PNG

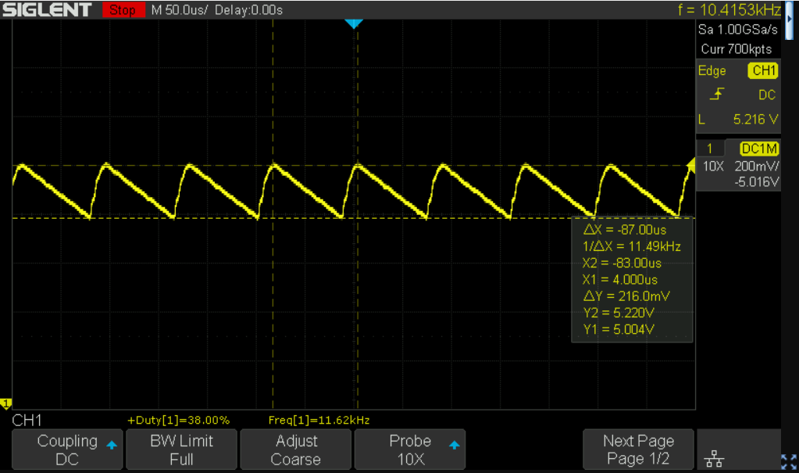
PCBAs/BMS/Validation/5V_Ripple_200u_inductor.PNG
