Voltworks-Garage/Hardware/PCBAs/BMS/Validation/DCDC turn on with precharge 560uF.JPG

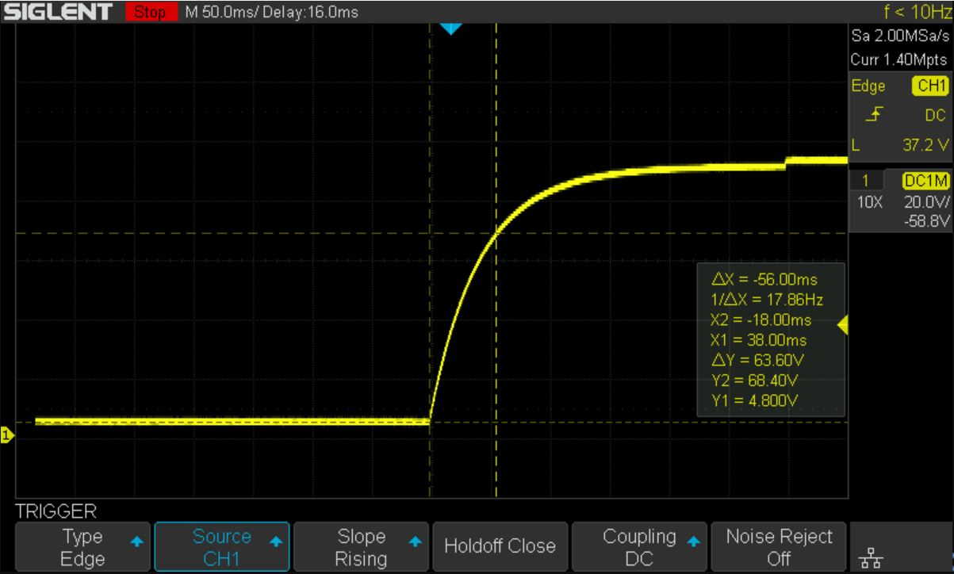
PCBAs/BMS/Validation/DCDC turn on with precharge 560uF.JPG
