Voltworks-Garage/Hardware/PCBAs/BodyController/Validation/Horn/Horn_Transient.png

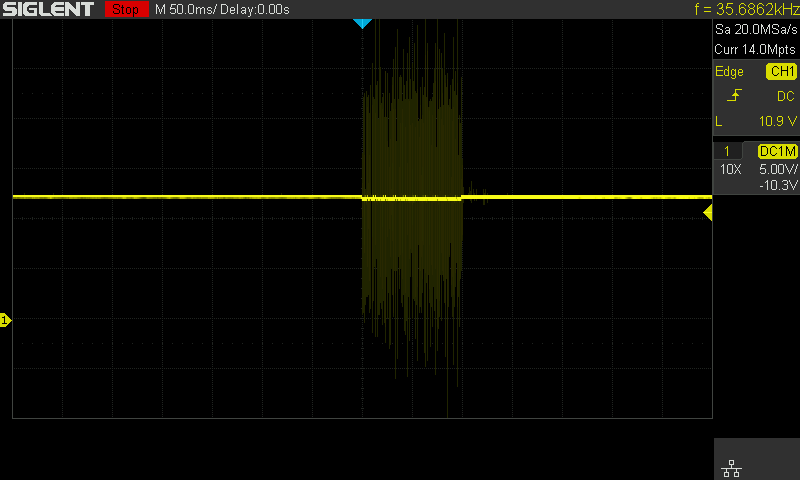
PCBAs/BodyController/Validation/Horn/Horn_Transient.png
