Voltworks-Garage/Hardware/(threads)

Thread 6 (2025-08-26):

BMS: need separate pre-charges for everything

zachleedogg, 2025-08-26:
Sharing a precharge for the whole HV bus does not work.

The DCDC comes up and start precharging its output which drags down the whole bus (just the load of charging output caps i think. Maybe consider just using a low value resistor (maybe 10ohms?) and hardware circuit to turn it off after specified period.

Also, consider HV digital output to control DCDC enable after the bus has been precharged for more reliable startup.

For now using the Sevcon internal precharge, but maybe not all controller brands will have this.

Thread 7 (2025-08-29):

BODY CONTROLLER: Update the CAN transceiver with something with lower sleep current

zachleedogg, 2025-08-29:
Current TCAN 1051 has 1.5mA sleep drain on the 5V pin. pick something that actually goes to sleep.

Thread 9 (2025-09-05):

Fix J1772 controller

zachleedogg, 2025-09-05:
Make sure to add a pull-down to the Pilot enable pin.
Add some digital inputs and a comparator for better duty cycle calculation.

Thread 10 (2025-10-03):

FAN/PUMP PWM pins should be low-side drivers

zachleedogg, 2025-10-03:
FAN and PUMP PWM pins are 5V tolerant, luckily, so they can operate in open drain mode, but in future, just use a low side driver.
