Voltworks-Garage/Hardware/Simulations/op-amp_tutorial.asc

C1: cap; 3n3
C2: cap; 3n3
R1: res; 120k
R2: res; 50k
R3: res; 200k
R4: res; 80k
R5: res; 20k
R6: res; 1k
R7: res; 20k
R8: res; 80k
U1: OP07
U2: OP07
V1: voltage; SINE(0 10 1k)
V2: voltage; 12
V3: voltage; 12
V4: voltage; -10
V5: voltage; SINE(0 10 1k)
V6: voltage; -10
Named nets: 0, 12V+, 12V-, out, in, out_2, in_2
.tran 100m
Adjust the duration of the simulation
Summing Inverting amplifier
non-inverting amplifier
https://www.electronics-tutorials.ws/opamp/opamp_4.html
https://www.electronics-tutorials.ws/opamp/opamp_3.html
voltage divider
https://ohmslawcalculator.com/voltage-divider-calculator
