Voltworks-Garage/Hardware/Simulations/PrecisionBatteryMeasurement.asc

C1: cap; .01µ; V=50
C2: cap; .01µ
R1: res; 79375; tol=.1 pwr=.1
R2: res; 20625; tol=.1 pwr=.1
R3: res; 10000; tol=1 pwr=.1
R4: res; 20000; tol=1 pwr=.1
R5: res; 20000
R6: res; 10000
U1: LT1006
U2: LT1006
V1: voltage; PWL(0 12 100m 16 200m 8)
V2: voltage; 3.3
V3: voltage; 5
Named nets: 0, vBatt, vRef, vBatDiv, vBatDivBuf, refOut
.tran 0 1000m 0 .1
