Voltworks-Garage/Hardware/Simulations/1772_Proximity.asc

R1: res; 330
R2: res; 330
R3: res; 150
R4: res; 330
S1: sw; Button
S2: sw; Handle
V1: voltage; 5
V2: voltage; PWL(0 0 1m 0 2m 5)
V3: voltage; PWL(0 0 1m 5)
Named nets: 0, Proximity, handle, button
.tran 3m
.model Handle SW(Ron=1 Roff=1Meg Vt=2.5 Vh=.5)
.model Button SW(Ron=1 Roff=1Meg Vt=2.5 Vh=.5)
