Voltworks-Garage/Hardware/Simulations/daisyChainLTC6802-2.asc

D1: diode; MURS120
D2: schottky; MBRS1100
D3: diode; MURS120
D4: zener; KDZV6_2B
M1: nmos; BSP89
M2: nmos; BSP89
M3: nmos; BSP89
Q1: npn; 2N3019
Q2: npn; 2N3019
Q3: npn; 2N3019
Q4: pnp; 2N5401
R1: res; 2.2k
R2: res; 2.2k
R3: res; 2k2
R4: res; 100
R5: res; 1k8
R6: res; 10k
R7: res; 34k
V1: voltage; 5
V2: voltage; 5
V3: voltage; 40
V4: voltage; 40
V5: voltage; PULSE(0 3.3 0 .01m .01m 1m 2m)
V6: voltage; PULSE(0 5 0 .01m .01m 1m 2m)
Named nets: 0, CLK_out, SDO
.tran 20m
