Voltworks-Garage/Hardware/Simulations/DCDC_Switched_Capacitor.asc

C1: cap; 10µ
C2: cap; 10µ
C3: cap; 10µ
C4: cap; 10µ
C5: cap; 10µ
C6: cap; 10µ
C7: cap; 10µ
C8: cap; 10µ
C9: cap; 10µ
C10: cap; 10µ
C11: cap; 10µ
C12: cap; 10µ
C13: cap; 10µ
C14: cap; 10µ
C15: cap; 10µ
C16: cap; 10µ
C17: cap; 10µ
C18: cap; 10µ
E1: e; 2
E2: e; 2
E3: e; 2
E4: e; 2
I1: current; 20
M1: nmos; IPB065N15N3
M2: nmos; IPB065N15N3
M3: nmos; IPB065N15N3
M4: nmos; IPB065N15N3
V1: voltage; 100
V2: voltage; PULSE(0 5 0 10n 10n .005m .010m)
V3: voltage; PULSE(0 5 .0055m 10n 10n .004m .01m)
Named nets: 0, V_PACK, vout, high, low
.tran 1m
.ic V(vout) = 5
