Voltworks-Garage/Hardware/Simulations/Draft6.asc

C1: cap; 1µ
C2: cap; 4µ7
C3: cap; 1µ
C4: cap; 100n
D1: schottky; MBRS1100
D2: schottky; MBRS1100
D3: schottky; MBRS1100
D4: zener; BZX84B15VL
D5: zener; BZX84B15VL
M1: nmos; BSC16DN25NS3
M2: pmos; IRFP9240
M3: nmos; BSP89
M4: pmos; IRFP9240
M5: nmos; BSP89
M6: nmos; BSC16DN25NS3
R1: res; 10k
R2: res; 10k
R3: res; 1k
R4: res; 20k
R5: res; 100k
R6: res; 50k
R7: res; 10k
R8: res; 100k
U1: PC817A
V1: voltage; 5
V2: voltage; PULSE(0 5 0 0 0 .005 .01)
V3: voltage; 100
V4: voltage; PULSE(0 5 .005 0 0 .005 .01)
V5: voltage; PULSE(0 5 0 0 0 .00005 .0001)
V6: voltage; PULSE(0 5 .00005 0 0 .00005 .0001)
V7: voltage; PWL(0 0 .01 0 .011 5 .02 5 .021 0)
V8: voltage; 5
Named nets: 0, out, cp_out, 100v, 5v
.tran 50m
.ic V(cp_out) = 0
