Voltworks-Garage/Hardware/Simulations/Draft8.asc

D1: diode; MMSD4148
D2: diode; MMSD4148
D3: diode; MMSD4148
M1: nmos; DAOTL66810UT
M2: nmos; DAOTL66810UT
M3: nmos; DAOTL66810UT
M4: nmos; DAOTL66810UT
M5: nmos; DAOTL66810UT
M6: nmos; DAOTL66810UT
R1: res; 10
R2: res; 10k
R3: res; 10k
R4: res; 10k
R5: res; 10
R6: res; 100k
R7: res; 100k
V1: voltage; 36
V2: voltage; 36
V3: voltage; PWL(0 0 100m 0 101m 10)
V4: voltage; 10
V5: voltage; 36
V6: voltage; 0
Named nets: 0
.tran 1
