Voltworks-Garage/Hardware/PCBAs/BodyController/BodyController_01/BodyController_01.kicad_pcb

## KiCad design PCBAs/BodyController/BodyController_01/BodyController_01.kicad_pcb (continued)

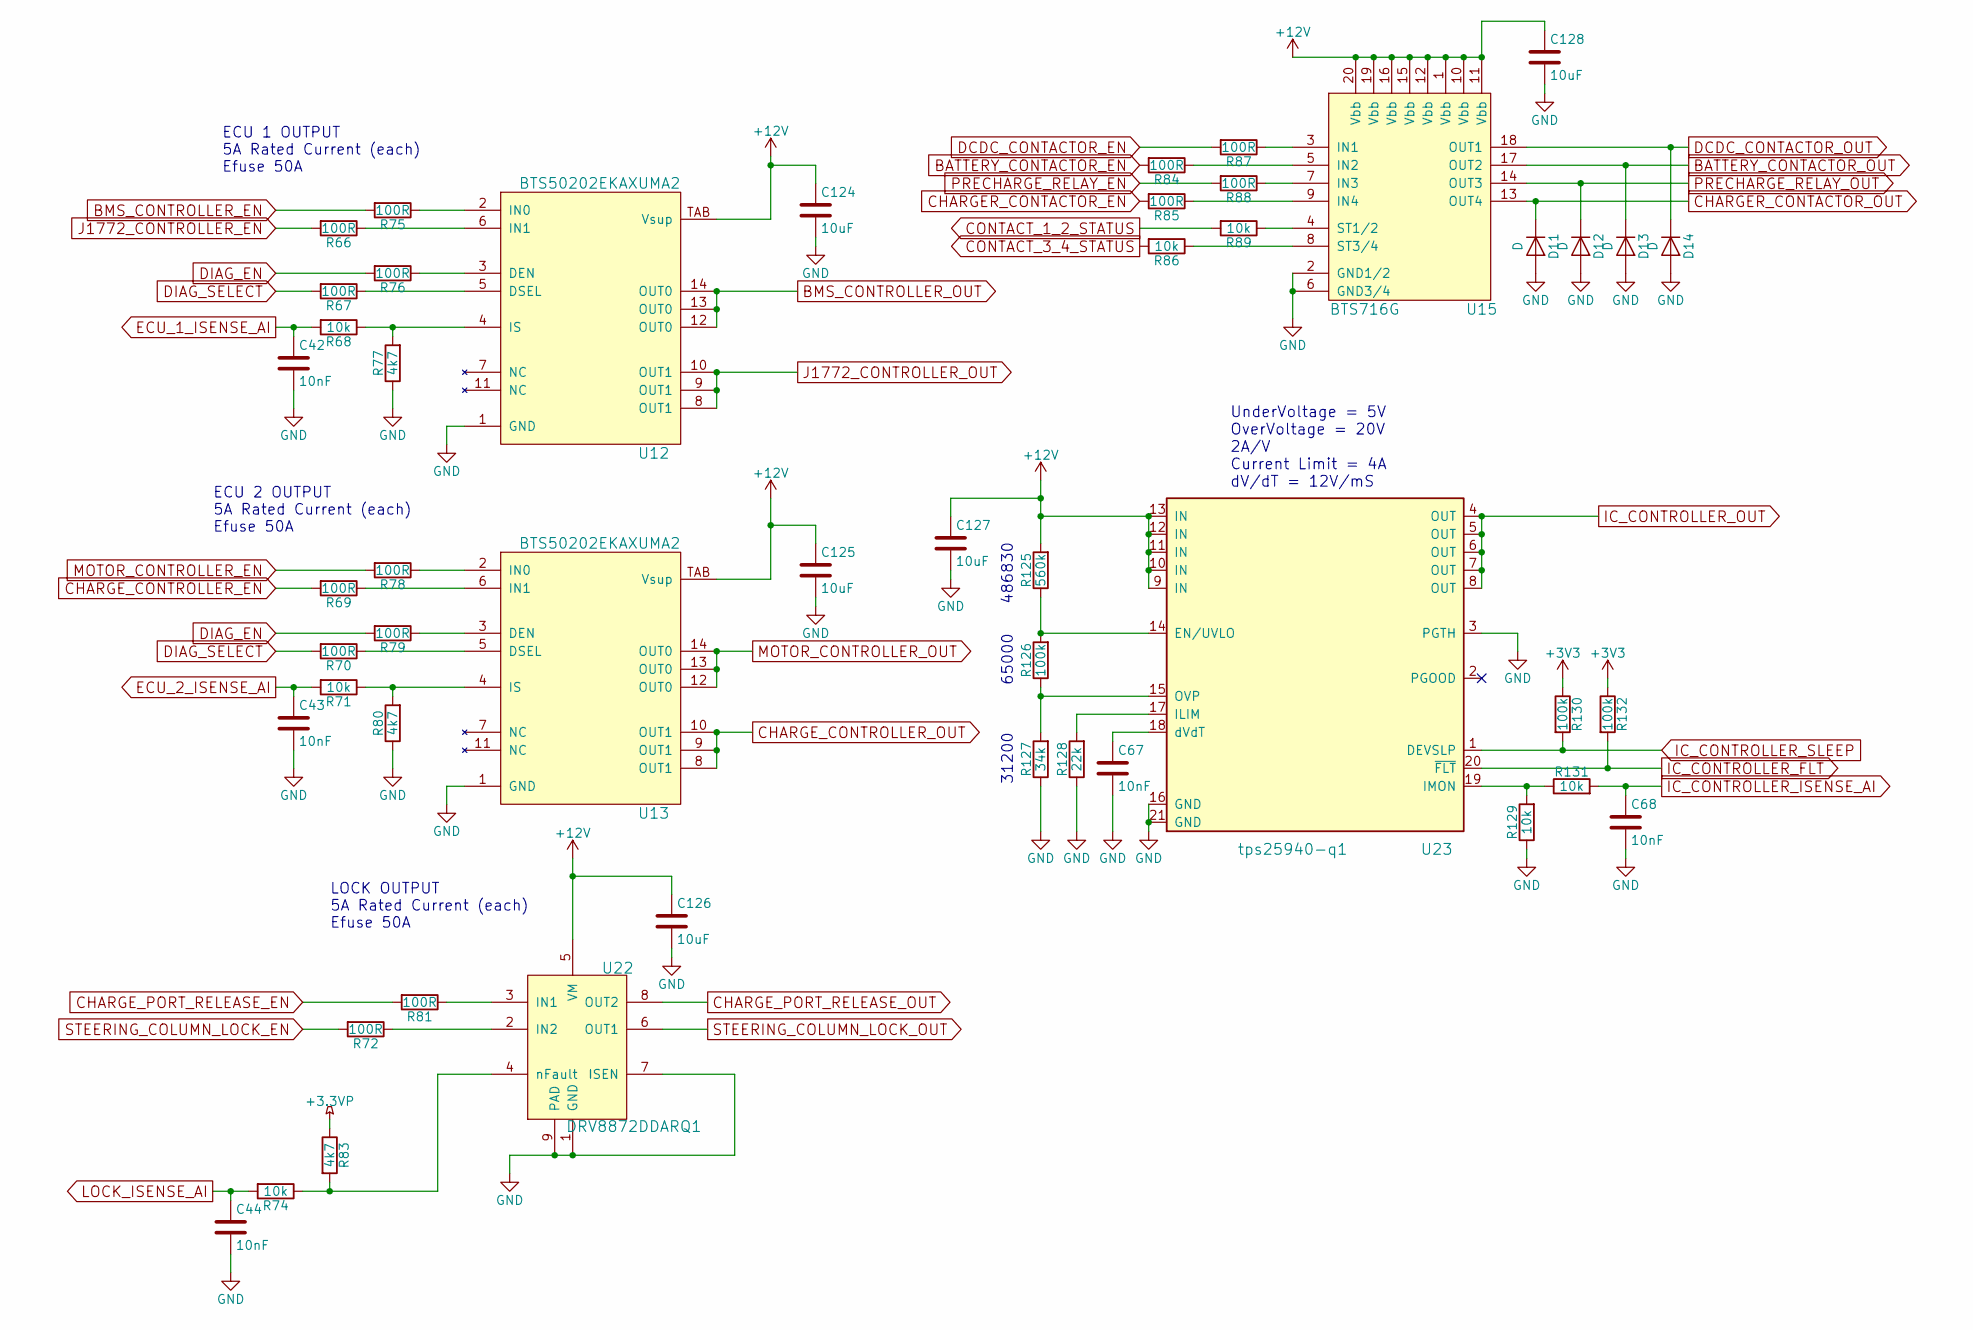
[picture p12: schematic HighSideDrivers_3.sch]

Parts:
C42, C43, C44, C67, C68: 10nF; C_0603; MPN CGA3E2X7R1H103K080AA
C124, C125, C126, C127, C128: 10uF; C_1206; MPN C1206C106M3RACAUTO
D11, D12, D13, D14: D; D_PowerDI-123; MPN DFLS1100Q-7
R66, R67, R69, R70, R72, R75, R76, R78, R79, R81, R84, R85, R87, R88: 100R; R_0603; MPN AC0603FR-07100RL
R68, R71, R74, R86, R89, R129, R131: 10k; R_0603; MPN AC0603FR-0710KL
R77, R80, R83: 4k7; R_0603; MPN AC0603FR-074K7L
R125: 560k; R_0603; MPN AC0603FR-07560KL
R126, R130, R132: 100k; R_0603; MPN AC0603FR-07100KL
R127: 34k; R_0603; MPN ERJ-3EKF3402V
R128: 22k; R_0603; MPN AC0603FR-0722KL
U12, U13: BTS50202EKAXUMA2; PG_DSO_14_40_EP; MPN BTS50202EKAXUMA2
U15: BTS716G; SOIC-20W_7.5x12.8mm_Pitch1.27mm; MPN BTS716GXUMA1
U22: DRV8872DDARQ1; HTSOP-8-1EP_3.9x4.9mm_Pitch1.27mm_ThermalVias; MPN DRV8872DDARQ1
U23: tps25940-q1; QFN-20-1EP_3x4mm_Pitch0.5mm; MPN TPS25940AQRVCRQ1

Connections:
+3.3VP: R83.1; also elsewhere on the board
+12V: C124.1, C125.1, C126.1, C127.1, C128.1, R125.2, U12.TAB (Vsup), U13.TAB (Vsup), U15.1 (Vbb), U15.10 (Vbb), U15.11 (Vbb), U15.12 (Vbb), U15.15 (Vbb), U15.16 (Vbb), U15.19 (Vbb), U15.20 (Vbb), U22.5 (VM), U23.9 (IN), U23.10 (IN), U23.11 (IN), U23.12 (IN), U23.13 (IN); also elsewhere on the board
BATTERY_CONTACTOR_EN: R84.2; also elsewhere on the board
BATTERY_CONTACTOR_OUT: D13.1 (K), U15.17 (OUT2); also elsewhere on the board
BMS_CONTROLLER_EN: R75.2; also elsewhere on the board
BMS_CONTROLLER_OUT: U12.12 (OUT0), U12.13 (OUT0), U12.14 (OUT0); also elsewhere on the board
CHARGER_CONTACTOR_EN: R85.2; also elsewhere on the board
CHARGER_CONTACTOR_OUT: D11.1 (K), U15.13 (OUT4); also elsewhere on the board
CHARGE_CONTROLLER_EN: R69.2; also elsewhere on the board
CHARGE_CONTROLLER_OUT: U13.8 (OUT1), U13.9 (OUT1), U13.10 (OUT1); also elsewhere on the board
CHARGE_PORT_RELEASE_EN: R81.2; also elsewhere on the board
CHARGE_PORT_RELEASE_OUT: U22.8 (OUT2); also elsewhere on the board
CONTACT_1_2_STATUS: R89.2; also elsewhere on the board
CONTACT_3_4_STATUS: R86.2; also elsewhere on the board
DCDC_CONTACTOR_EN: R87.2; also elsewhere on the board
DCDC_CONTACTOR_OUT: D14.1 (K), U15.18 (OUT1); also elsewhere on the board
DIAG_EN: R76.2, R79.2; also elsewhere on the board
DIAG_SELECT: R67.2, R70.2; also elsewhere on the board
ECU_1_ISENSE_AI: C42.1, R68.2; also elsewhere on the board
ECU_2_ISENSE_AI: C43.1, R71.2; also elsewhere on the board
GND: C42.2, C43.2, C44.2, C67.2, C68.2, C124.2, C125.2, C126.2, C127.2, C128.2, D11.2 (A), D12.2 (A), D13.2 (A), D14.2 (A), R77.1, R80.1, R127.1, R128.1, R129.1, U12.1 (GND), U13.1 (GND), U15.2 (GND1/2), U15.6 (GND3/4), U22.1 (GND), U22.7 (ISEN), U22.9 (PAD), U23.3 (PGTH), U23.16 (GND), U23.21 (GND); also elsewhere on the board
IC_CONTROLLER_ISENSE_AI: C68.1, R131.2; also elsewhere on the board
IC_CONTROLLER_OUT: U23.4 (OUT), U23.5 (OUT), U23.6 (OUT), U23.7 (OUT), U23.8 (OUT); also elsewhere on the board
IC_CONTROLLER_SLEEP: R130.2, U23.1 (DEVSLP); also elsewhere on the board
IC_CONTROLLER_~FLT: R132.2, U23.20 (~FLT); also elsewhere on the board
J1772_CONTROLLER_EN: R66.2; also elsewhere on the board
J1772_CONTROLLER_OUT: U12.8 (OUT1), U12.9 (OUT1), U12.10 (OUT1); also elsewhere on the board
LOCK_ISENSE_AI: C44.1, R74.2; also elsewhere on the board
MOTOR_CONTROLLER_EN: R78.2; also elsewhere on the board
MOTOR_CONTROLLER_OUT: U13.12 (OUT0), U13.13 (OUT0), U13.14 (OUT0); also elsewhere on the board
unnamed: C67.1, U23.18 (dVdT)
unnamed: R66.1, U12.6 (IN1)
unnamed: R67.1, U12.5 (DSEL)
unnamed: R68.1, R77.2, U12.4 (IS)
unnamed: R69.1, U13.6 (IN1)
unnamed: R70.1, U13.5 (DSEL)
unnamed: R71.1, R80.2, U13.4 (IS)
unnamed: R72.1, U22.2 (IN2)
unnamed: R74.1, R83.2, U22.4 (nFault)
unnamed: R75.1, U12.2 (IN0)
unnamed: R76.1, U12.3 (DEN)
unnamed: R78.1, U13.2 (IN0)
unnamed: R79.1, U13.3 (DEN)
unnamed: R81.1, U22.3 (IN1)
unnamed: R84.1, U15.5 (IN2)
unnamed: R85.1, U15.9 (IN4)
unnamed: R86.1, U15.8 (ST3/4)
unnamed: R87.1, U15.3 (IN1)
unnamed: R88.1, U15.7 (IN3)
unnamed: R89.1, U15.4 (ST1/2)
unnamed: R125.1, R126.2, U23.14 (EN/UVLO)
unnamed: R126.1, R127.2, U23.15 (OVP)
unnamed: R128.2, U23.17 (ILIM)
unnamed: R129.2, R131.1, U23.19 (IMON)
PRECHARGE_RELAY_EN: R88.2; also elsewhere on the board
PRECHARGE_RELAY_OUT: D12.1 (K), U15.14 (OUT3); also elsewhere on the board
STEERING_COLUMN_LOCK_EN: R72.2; also elsewhere on the board
STEERING_COLUMN_LOCK_OUT: U22.6 (OUT1); also elsewhere on the board

Notes on the sheet:
LOCK OUTPUT 5A Rated Current (each) Efuse 50A
ECU 2 OUTPUT 5A Rated Current (each) Efuse 50A
ECU 1 OUTPUT 5A Rated Current (each) Efuse 50A
486830
65000
31200
UnderVoltage = 5V OverVoltage = 20V 2A/V Current Limit = 4A dV/dT = 12V/mS

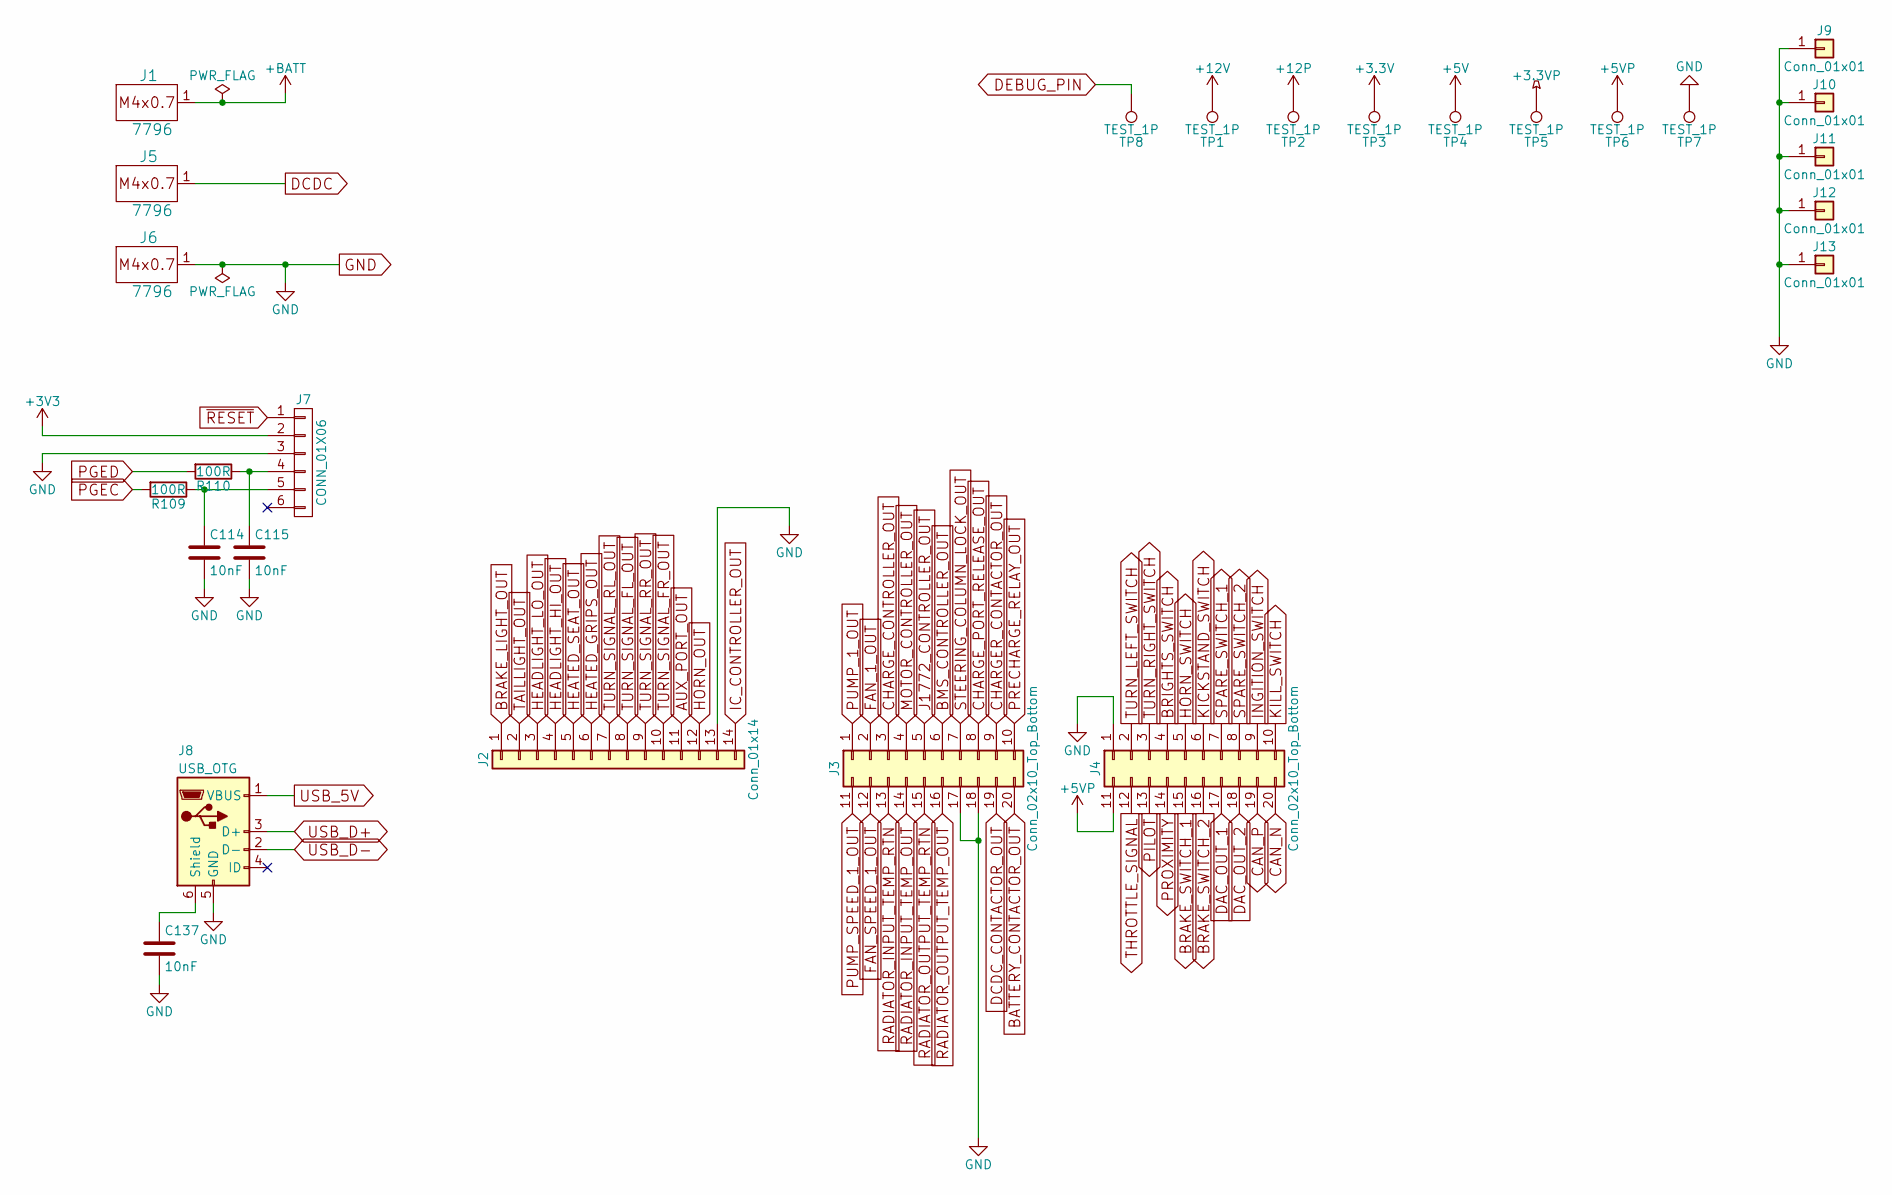
[picture p13: schematic Connectors.sch]

Parts:
C114, C115, C137: 10nF; C_0603; MPN CGA3E2X7R1H103K080AA
J1, J5, J6: 7796; MPN 7796
J2: Conn_01x14; 34772-0140; MPN 34772-0140
J3: Conn_02x10_Top_Bottom; 34690-0200; MPN 34690-0201
J4: Conn_02x10_Top_Bottom; 34690-0200; MPN 34690-0203
J7: CONN_01X06; Pin_Header_Straight_1x06_Pitch2.54mm
J8: USB_OTG; USB_Micro-B_Vertical_Molex-105133-0001; MPN 1051330001
J9, J10, J11, J12, J13: Conn_01x01; MountingHole_3.2mm_M3_Pad_Via
R109, R110: 100R; R_0603; MPN AC0603FR-07100RL
TP1, TP2, TP3, TP4, TP5, TP6, TP7, TP8: TEST_1P; Test_Point_Keystone_5019_Minature; MPN 5015

Connections:
+3.3VP: TP5.1; also elsewhere on the board
+5V: TP4.1; also elsewhere on the board
+5VP: J4.11, TP6.1; also elsewhere on the board
+12P: TP2.1; also elsewhere on the board
+12V: TP1.1; also elsewhere on the board
+BATT: J1.1; also elsewhere on the board
AUX_PORT_OUT: J2.11; also elsewhere on the board
BATTERY_CONTACTOR_OUT: J3.20; also elsewhere on the board
BMS_CONTROLLER_OUT: J3.6; also elsewhere on the board
BRAKE_LIGHT_OUT: J2.1; also elsewhere on the board
BRAKE_SWITCH_1: J4.15; also elsewhere on the board
BRAKE_SWITCH_2: J4.16; also elsewhere on the board
BRIGHTS_SWITCH: J4.4; also elsewhere on the board
CAN_N: J4.20; also elsewhere on the board
CAN_P: J4.19; also elsewhere on the board
CHARGER_CONTACTOR_OUT: J3.9; also elsewhere on the board
CHARGE_CONTROLLER_OUT: J3.3; also elsewhere on the board
CHARGE_PORT_RELEASE_OUT: J3.8; also elsewhere on the board
DAC_OUT_1: J4.17; also elsewhere on the board
DAC_OUT_2: J4.18; also elsewhere on the board
DCDC: J5.1; also elsewhere on the board
DCDC_CONTACTOR_OUT: J3.19; also elsewhere on the board
DEBUG_PIN: TP8.1; also elsewhere on the board
FAN_1_OUT: J3.2; also elsewhere on the board
FAN_SPEED_1_OUT: J3.12; also elsewhere on the board
GND: C114.2, C115.2, C137.2, J2.13, J3.13, J3.15, J3.17, J3.18, J4.1, J6.1, J7.3, J8.5 (GND), J9.1, J10.1, J11.1, J12.1, J13.1, TP7.1; also elsewhere on the board
HEADLIGHT_HI_OUT: J2.4; also elsewhere on the board
HEADLIGHT_LO_OUT: J2.3; also elsewhere on the board
HEATED_GRIPS_OUT: J2.6; also elsewhere on the board
HEATED_SEAT_OUT: J2.5; also elsewhere on the board
HORN_OUT: J2.12; also elsewhere on the board
HORN_SWITCH: J4.5; also elsewhere on the board
IC_CONTROLLER_OUT: J2.14; also elsewhere on the board
INGITION_SWITCH: J4.9; also elsewhere on the board
J1772_CONTROLLER_OUT: J3.5; also elsewhere on the board
KICKSTAND_SWITCH: J4.6; also elsewhere on the board
KILL_SWITCH: J4.10; also elsewhere on the board
MOTOR_CONTROLLER_OUT: J3.4; also elsewhere on the board
unnamed: C114.1, J7.5, R109.1
unnamed: C115.1, J7.4, R110.1
unnamed: C137.1, J8.6 (Shield)
PGEC: R109.2; also elsewhere on the board
PGED: R110.2; also elsewhere on the board
PILOT: J4.13; also elsewhere on the board
PRECHARGE_RELAY_OUT: J3.10; also elsewhere on the board
PROXIMITY: J4.14; also elsewhere on the board
PUMP_1_OUT: J3.1; also elsewhere on the board
PUMP_SPEED_1_OUT: J3.11; also elsewhere on the board
RADIATOR_INPUT_TEMP_OUT: J3.14; also elsewhere on the board
RADIATOR_OUTPUT_TEMP_OUT: J3.16; also elsewhere on the board
SPARE_SWITCH_1: J4.7; also elsewhere on the board
SPARE_SWITCH_2: J4.8; also elsewhere on the board
STEERING_COLUMN_LOCK_OUT: J3.7; also elsewhere on the board
TAILLIGHT_OUT: J2.2; also elsewhere on the board
THROTTLE_SIGNAL: J4.12; also elsewhere on the board
TURN_LEFT_SWITCH: J4.2; also elsewhere on the board
TURN_RIGHT_SWITCH: J4.3; also elsewhere on the board
TURN_SIGNAL_FL_OUT: J2.8; also elsewhere on the board
TURN_SIGNAL_FR_OUT: J2.10; also elsewhere on the board
TURN_SIGNAL_RL_OUT: J2.7; also elsewhere on the board
TURN_SIGNAL_RR_OUT: J2.9; also elsewhere on the board
USB_5V: J8.1 (VBUS); also elsewhere on the board
USB_D+: J8.3 (D+); also elsewhere on the board
USB_D-: J8.2 (D-); also elsewhere on the board
~RESET: J7.1; also elsewhere on the board

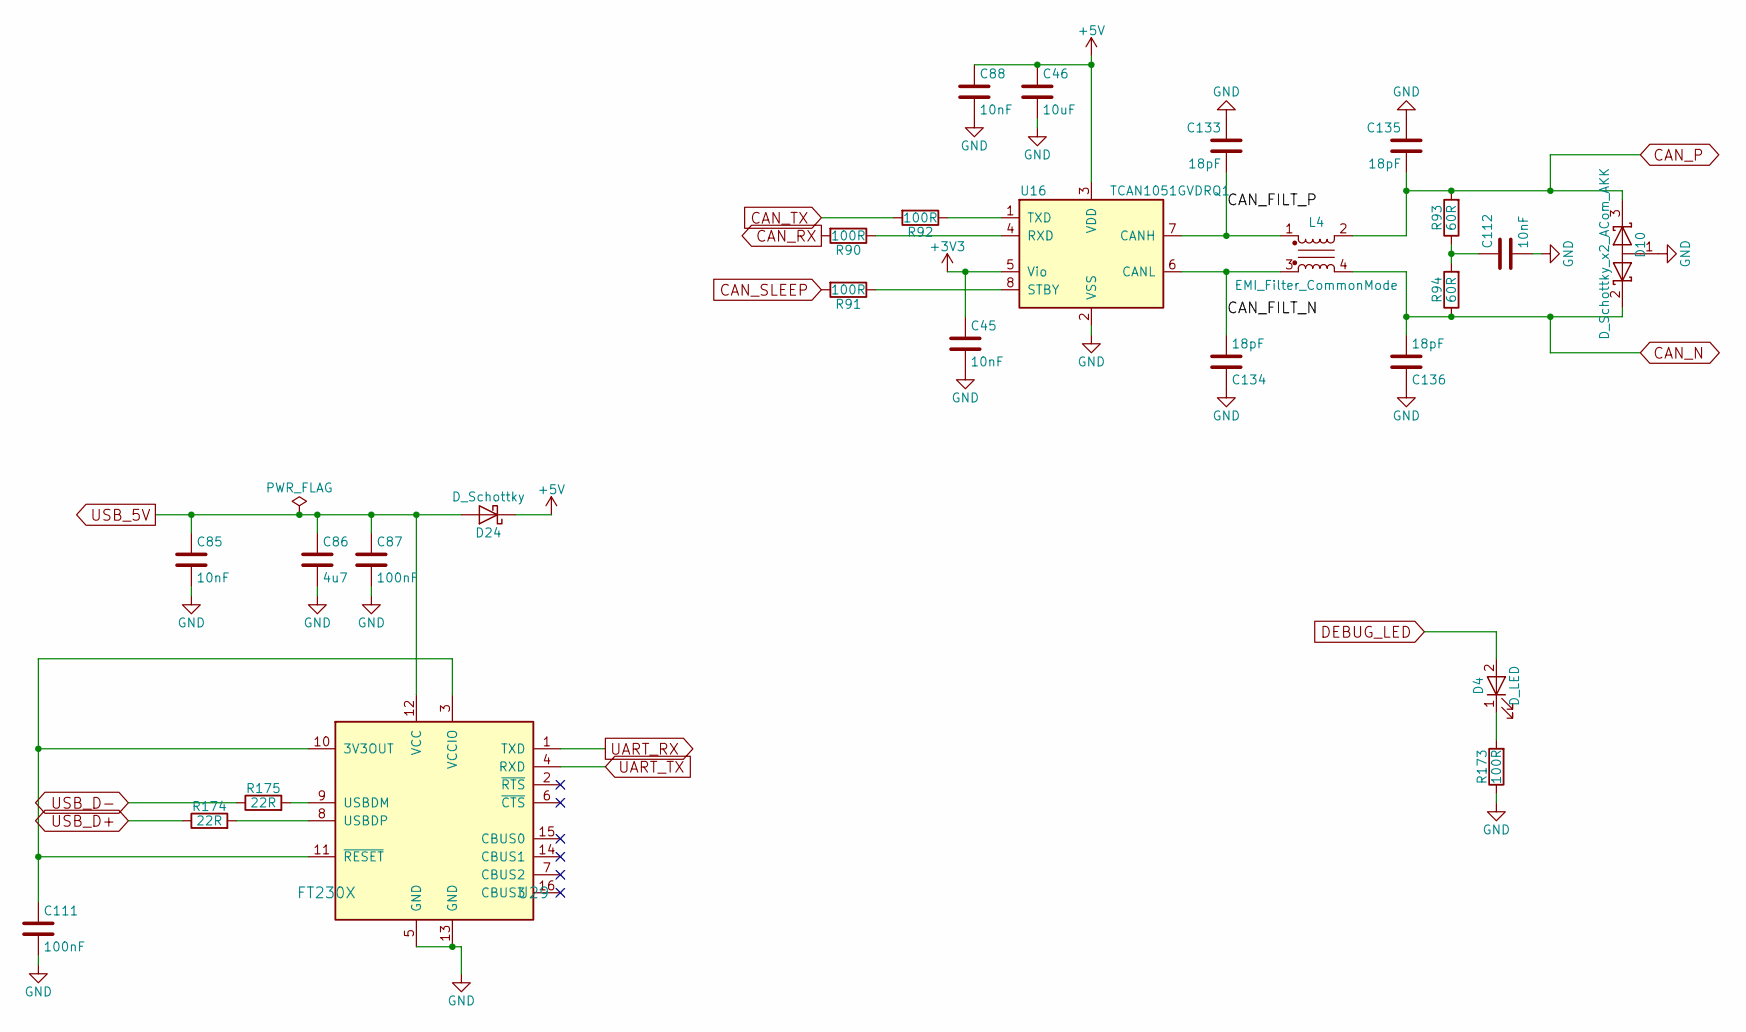
[picture p14: schematic Communication.sch]

Parts:
C45, C85, C88, C112: 10nF; C_0603; MPN CGA3E2X7R1H103K080AA
C46: 10uF; C_1206; MPN C1206C106M3RACAUTO
C86: 4u7; C_1206; MPN CGA5L3X7R1H475K160AE
C87, C111: 100nF; C_0603; MPN GCM188R71H104KA57D
C133, C134, C135, C136: 18pF; C_0603; MPN CGA3E2C0G1H180J080AA
D4: D_LED; D_0603; MPN LTST-C191KRKT
D10: D_Schottky_x2_ACom_AKK; D_SOT-23_ANK; MPN ESDCAN24-2BLY
D24: D_Schottky; D_SOD-123; MPN PMEG6020AELRX
L4: EMI_Filter_CommonMode; ACT45B; MPN B82787C0513H002
R90, R91, R92, R173: 100R; R_0603; MPN AC0603FR-07100RL
R93, R94: 60R; R_2512; MPN RMCF2512JT62R0
R174, R175: 22R; R_0603; MPN AC0603FR-0722RL
U16: TCAN1051GVDRQ1; SOIC-8_3.9x4.9mm_Pitch1.27mm; MPN TCAN1051GVDRQ1
U29: FT230X; SSOP-16_3.9x4.9mm_Pitch0.635mm; MPN FT230XS-R

Connections:
+5V: C46.1, C88.1, D24.1 (K), U16.3 (VDD); also elsewhere on the board
/TopLevel/Communication/CAN_FILT_N: C134.2, L4.3, U16.6 (CANL)
/TopLevel/Communication/CAN_FILT_P: C133.2, L4.1, U16.7 (CANH)
CAN_N: C136.2, D10.2 (K), L4.4, R94.1; also elsewhere on the board
CAN_P: C135.2, D10.3 (K), L4.2, R93.2; also elsewhere on the board
CAN_RX: R90.2; also elsewhere on the board
CAN_SLEEP: R91.2; also elsewhere on the board
CAN_TX: R92.2; also elsewhere on the board
DEBUG_LED: D4.2 (A); also elsewhere on the board
GND: C45.2, C46.2, C85.2, C86.2, C87.2, C88.2, C111.2, C112.2, C133.1, C134.1, C135.1, C136.1, D10.1 (A), R173.1, U16.2 (VSS), U29.5 (GND), U29.13 (GND); also elsewhere on the board
unnamed: C111.1, U29.3 (VCCIO), U29.10 (3V3OUT), U29.11 (~RESET)
unnamed: C112.1, R93.1, R94.2
unnamed: D4.1 (K), R173.2
unnamed: R90.1, U16.4 (RXD)
unnamed: R91.1, U16.8 (STBY)
unnamed: R92.1, U16.1 (TXD)
unnamed: R174.2, U29.8 (USBDP)
unnamed: R175.2, U29.9 (USBDM)
UART_RX: U29.1 (TXD); also elsewhere on the board
UART_TX: U29.4 (RXD); also elsewhere on the board
USB_5V: C85.1, C86.1, C87.1, D24.2 (A), U29.12 (VCC); also elsewhere on the board
USB_D+: R174.1; also elsewhere on the board
USB_D-: R175.1; also elsewhere on the board

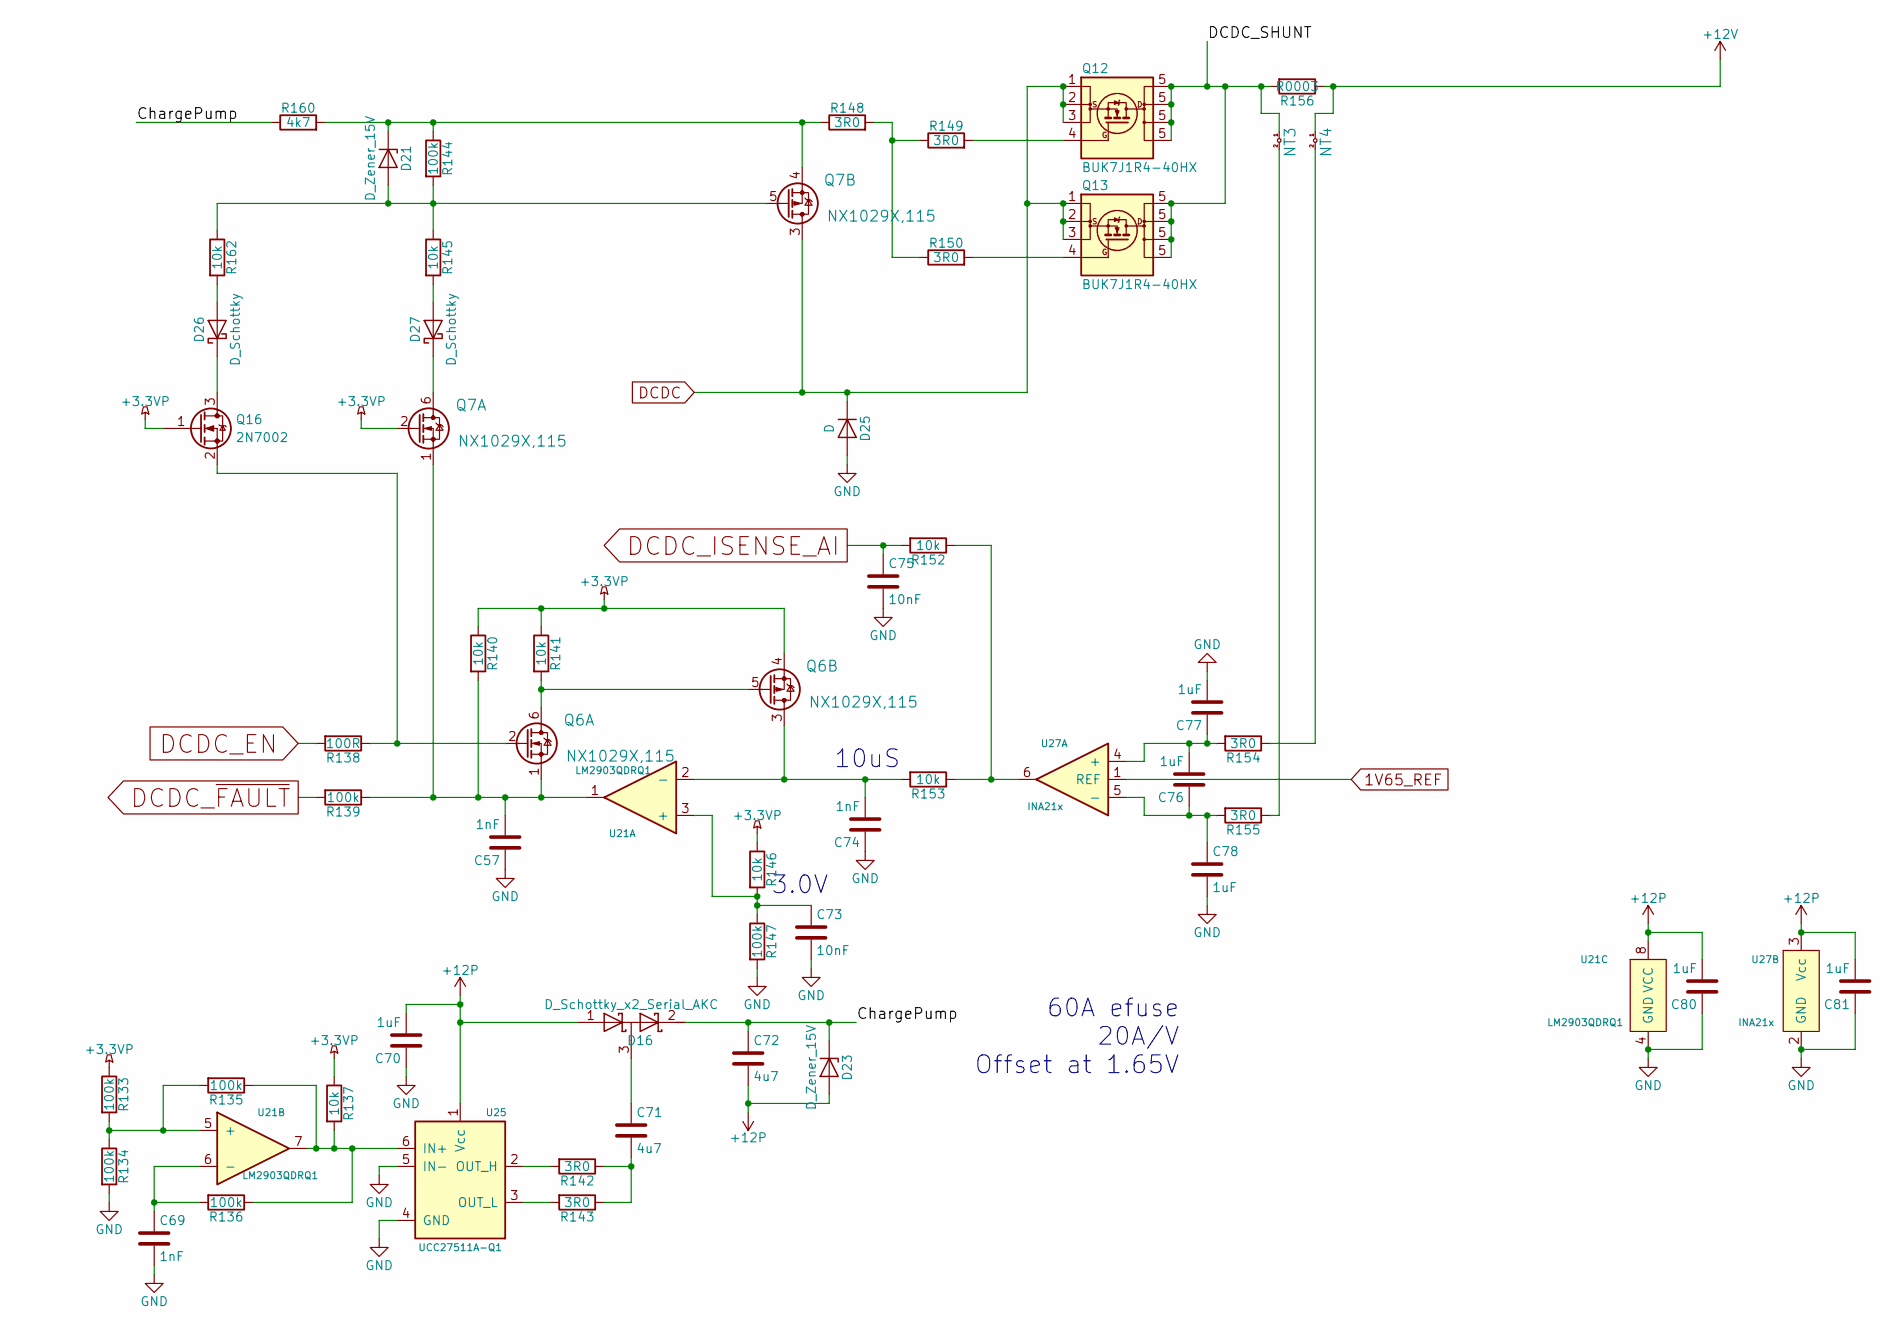
[picture p15: schematic DCDC.sch]

Parts:
C57, C69, C74: 1nF; C_0603; MPN CGA3E2X7R1H102K080AA
C70, C76, C77, C78, C80, C81: 1uF; C_0805; MPN CGA4J3X7R1H105M125AE
C71, C72: 4u7; C_1206; MPN CGA5L3X7R1H475K160AE
C73, C75: 10nF; C_0603; MPN CGA3E2X7R1H103K080AA
D16: D_Schottky_x2_Serial_AKC; SOT-23; MPN BAT54SFILMY
D21, D23: D_Zener_15V; D_SOD-123; MPN MMSZ5245BT1G
D25: D; SOT1289; MPN PMEG060V100EPDZ
D26, D27: D_Schottky; D_SOD-323; MPN BAS170WE6327HTSA1
NT3, NT4: Net_Tie-0.5mm
Q6, Q7: NX1029X,115; SOT-666; MPN NX1029X,115
Q12, Q13: BUK7J1R4-40HX; TDSON-8-1; MPN BUK7J1R4-40HX
Q16: 2N7002; SOT-23; MPN 2N7002P,215
R133, R134, R135, R136, R139, R144, R147: 100k; R_0603; MPN AC0603FR-07100KL
R137, R140, R141, R145, R146, R152, R153, R162: 10k; R_0603; MPN AC0603FR-0710KL
R138: 100R; R_0603; MPN AC0603FR-07100RL
R142, R143, R148, R149, R150, R154, R155: 3R0; R_0603; MPN ERJ-3GEYJ3R0V
R156: R0003; SMD-2512_Pol; MPN HCS2512FTL300
R160: 4k7; R_0603; MPN AC0603FR-074K7L
U21: LM2903QDRQ1; TSSOP-8_3x4.4mm_Pitch0.65mm; MPN LM2903AVQPWRG4Q1
U25: UCC27511A-Q1; SOT-23-6; MPN UCC27511AQDBVRQ1
U27: INA21x; SOT-363_SC-70-6; MPN INA214AQDCKRQ1

Connections:
1V65_REF: U27.1 (REF); also elsewhere on the board
+3.3VP: Q6.4, Q7.2, Q16.1 (G), R133.1, R137.1, R140.1, R141.1, R146.1; also elsewhere on the board
+12P: C70.2, C72.2, C80.2, C81.2, D16.1 (A), D23.2 (A), U21.8 (VCC), U25.1 (Vcc), U27.3 (Vcc); also elsewhere on the board
+12V: NT4.1, R156.1; also elsewhere on the board
/TopLevel/DCDC/ChargePump: C72.1, D16.2 (K), D23.1 (K), R160.1
/TopLevel/DCDC/DCDC_SHUNT: NT3.1, Q12.5 (D), Q13.5 (D), R156.2
DCDC: D25.1 (K), Q7.3, Q12.1 (S), Q12.2 (S), Q12.3 (S), Q13.1 (S), Q13.2 (S), Q13.3 (S); also elsewhere on the board
DCDC_EN: R138.2; also elsewhere on the board
DCDC_ISENSE_AI: C75.1, R152.2; also elsewhere on the board
DCDC_~FAULT: R139.2; also elsewhere on the board
GND: C57.1, C69.2, C70.1, C73.2, C74.1, C75.2, C77.2, C78.2, C80.1, C81.1, D25.2 (A), R134.2, R147.2, U21.4 (GND), U25.4 (GND), U25.5 (IN-), U27.2 (GND); also elsewhere on the board
unnamed: C57.2, Q6.1, Q7.1, R139.1, R140.2, U21.1
unnamed: C69.1, R136.2, U21.6 (-)
unnamed: C71.1, D16.3 (common)
unnamed: C71.2, R142.1, R143.1
unnamed: C73.1, R146.2, R147.1, U21.3 (+)
unnamed: C74.2, Q6.3, R153.2, U21.2 (-)
unnamed: C76.1, C78.1, R155.2, U27.5 (-)
unnamed: C76.2, C77.1, R154.2, U27.4 (+)
unnamed: D21.1 (K), Q7.4, R144.1, R148.1, R160.2
unnamed: D21.2 (A), Q7.5, R144.2, R145.1, R162.1
unnamed: D26.1 (K), Q16.3 (D)
unnamed: D26.2 (A), R162.2
unnamed: D27.1 (K), Q7.6
unnamed: D27.2 (A), R145.2
unnamed: NT3.2, R155.1
unnamed: NT4.2, R154.1
unnamed: Q6.5, Q6.6, R141.2
unnamed: Q12.4 (G), R149.2
unnamed: Q13.4 (G), R150.2
unnamed: Q6.2, Q16.2 (S), R138.1
unnamed: R133.2, R134.1, R135.2, U21.5 (+)
unnamed: R135.1, R136.1, R137.2, U21.7, U25.6 (IN+)
unnamed: R142.2, U25.2 (OUT_H)
unnamed: R143.2, U25.3 (OUT_L)
unnamed: R148.2, R149.1, R150.1
unnamed: R152.1, R153.1, U27.6

Notes on the sheet:
60A efuse 20A/V Offset at 1.65V
3.0V
10uS

Schematic: PowerRails.sch

Parts:
C10, C28, C29, C51, C52, C54: 10nF; C_0603; MPN CGA3E2X7R1H103K080AA
C23, C25, C27, C47, C48, C84: 4u7; C_1206; MPN CGA5L3X7R1H475K160AE
C24, C30: 47uF; CP_Elec_6.3x7.7; MPN EMHJ350ADA470MF80G
C26, C49, C55, C56, C113: 10uF; C_1206; MPN C1206C106M3RACAUTO
C50, C83: 100nF; C_0603; MPN GCM188R71H104KA57D
C53: 18pF; C_0603; MPN CGA3E2C0G1H180J080AA
D1, D2, D3, D6, D7: D_Schottky; D_SOD-123; MPN PMEG6020AELRX
D17: D_Schottky; D_SOD-323; MPN BAS170WE6327HTSA1
L2: Ferrite_Bead; L_0603; MPN MPZ1608S300ATDH5
L3: 10uH; Inductor_Taiyo-Yuden_NR-60xx; MPN NRS6045T100MMGKV
Q5, Q17: Q_PMOS_GSD; SOT-23; MPN BSS84AK,215
Q10: NX1029X,115; SOT-666; MPN NX1029X,115
R3, R104: 34k; R_0603; MPN ERJ-3EKF3402V
R4, R105: 4k7; R_0603; MPN AC0603FR-074K7L
R23: 560k; R_0603; MPN AC0603FR-07560KL
R24, R108: 150k; R_0603; MPN AC0603FR-07150KL
R99: 49k9; R_0603; MPN AC0603FR-0749K9L
R100: 100k; R_0603; MPN AC0603FR-07100KL
R101: 10k; R_0603; MPN AC0603FR-0710KL
R102, R103: 3R0; R_0603; MPN ERJ-3GEYJ3R0V
R106: 22R; R_0603; MPN AC0603FR-0722RL
R107: 845k; R_0603; MPN RMCF0603FT845K
U17: TPS70950QDBVRQ1; SOT-23-5; MPN TPS70950QDBVRQ1
U18, U19: TPS70933QDBVRQ1; SOT-23-5; MPN TPS70933QDBVRQ1
U20: LMR140x0; HTSOP-8-1EP_3.9x4.9mm_Pitch1.27mm_ThermalVias; MPN LMR14020SQDDARQ1

Connections:
12P_MONITOR_AI: C52.1, D17.1 (K), R104.2, R105.1; also elsewhere on the board
12V_MONITOR_AI: C10.1, R3.2, R4.1; also elsewhere on the board
+3.3VP: C49.1, U19.5 (OUT); also elsewhere on the board
+5V: C23.1, C54.1, C55.1, C56.1, L3.2, R106.1, U18.1 (IN), U18.3 (EN); also elsewhere on the board
+5VP: C113.1, U17.5 (OUT); also elsewhere on the board
+12P: Q10.3; also elsewhere on the board
+12V: D1.2 (A), D2.2 (A), D6.2 (A), D7.2 (A), Q17.2 (S); also elsewhere on the board
+BATT: Q5.2 (S); also elsewhere on the board
/TopLevel/PowerRails/buck_bt: C50.2, U20.1
/TopLevel/PowerRails/buck_fb: C53.2, R107.2, R108.1, U20.5
/TopLevel/PowerRails/buck_freq: R99.1, U20.4
/TopLevel/PowerRails/buck_holdup: C24.1, C25.1, D1.1 (K), L2.2
/TopLevel/PowerRails/buck_input: C27.1, C28.1, L2.1, R23.1, U20.2
/TopLevel/PowerRails/buck_ss: C29.1, U20.6
/TopLevel/PowerRails/buck_sw: D3.1 (K), L3.1, R102.2, R103.1, U20.8
/TopLevel/PowerRails/buck_uvlo: R23.2, R24.1, U20.3
DIVIDER_EN: C83.2, Q5.1 (G), Q10.5, Q17.1 (G), R100.2, R101.1
GND: C10.2, C23.2, C24.2, C25.2, C26.2, C27.2, C28.2, C29.2, C30.2, C47.2, C48.2, C49.2, C51.1, C52.2, C54.2, C55.2, C56.2, C84.2, C113.2, D3.2 (A), D17.2 (A), Q10.1, R4.2, R24.2, R99.2, R105.2, R108.2, U17.2 (GND), U18.2 (GND), U19.2 (GND), U20.7, U20.9; also elsewhere on the board
unnamed: C30.1, C48.1, C83.1, D2.1 (K), Q10.4, R100.1
unnamed: C47.1, D6.1 (K), U19.1 (IN)
unnamed: C50.1, R103.2
unnamed: C51.2, R102.1
unnamed: C53.1, R106.2, R107.1
unnamed: C84.1, D7.1 (K), U17.1 (IN)
unnamed: Q5.3 (D), R104.1
unnamed: Q10.6, R101.2
unnamed: Q17.3 (D), R3.1
SW_EN: Q10.2, U17.3 (EN), U19.3 (EN); also elsewhere on the board

Notes on the sheet:
12V_SW
Buck Converter: 5V 2A Output 3V UVLO 500kHz switching frequency 20mS soft start
TODO: set UVLO, Freq, SS, Feedback
5V Buck Regulator
3V3 LDO
5V_SW_EXT
3V3_SW LDO
