Voltworks-Garage/Hardware/PCBAs/BodyController/BodyController_01/BodyController_01.kicad_pcb

## KiCad design PCBAs/BodyController/BodyController_01/BodyController_01.kicad_pcb (continued)

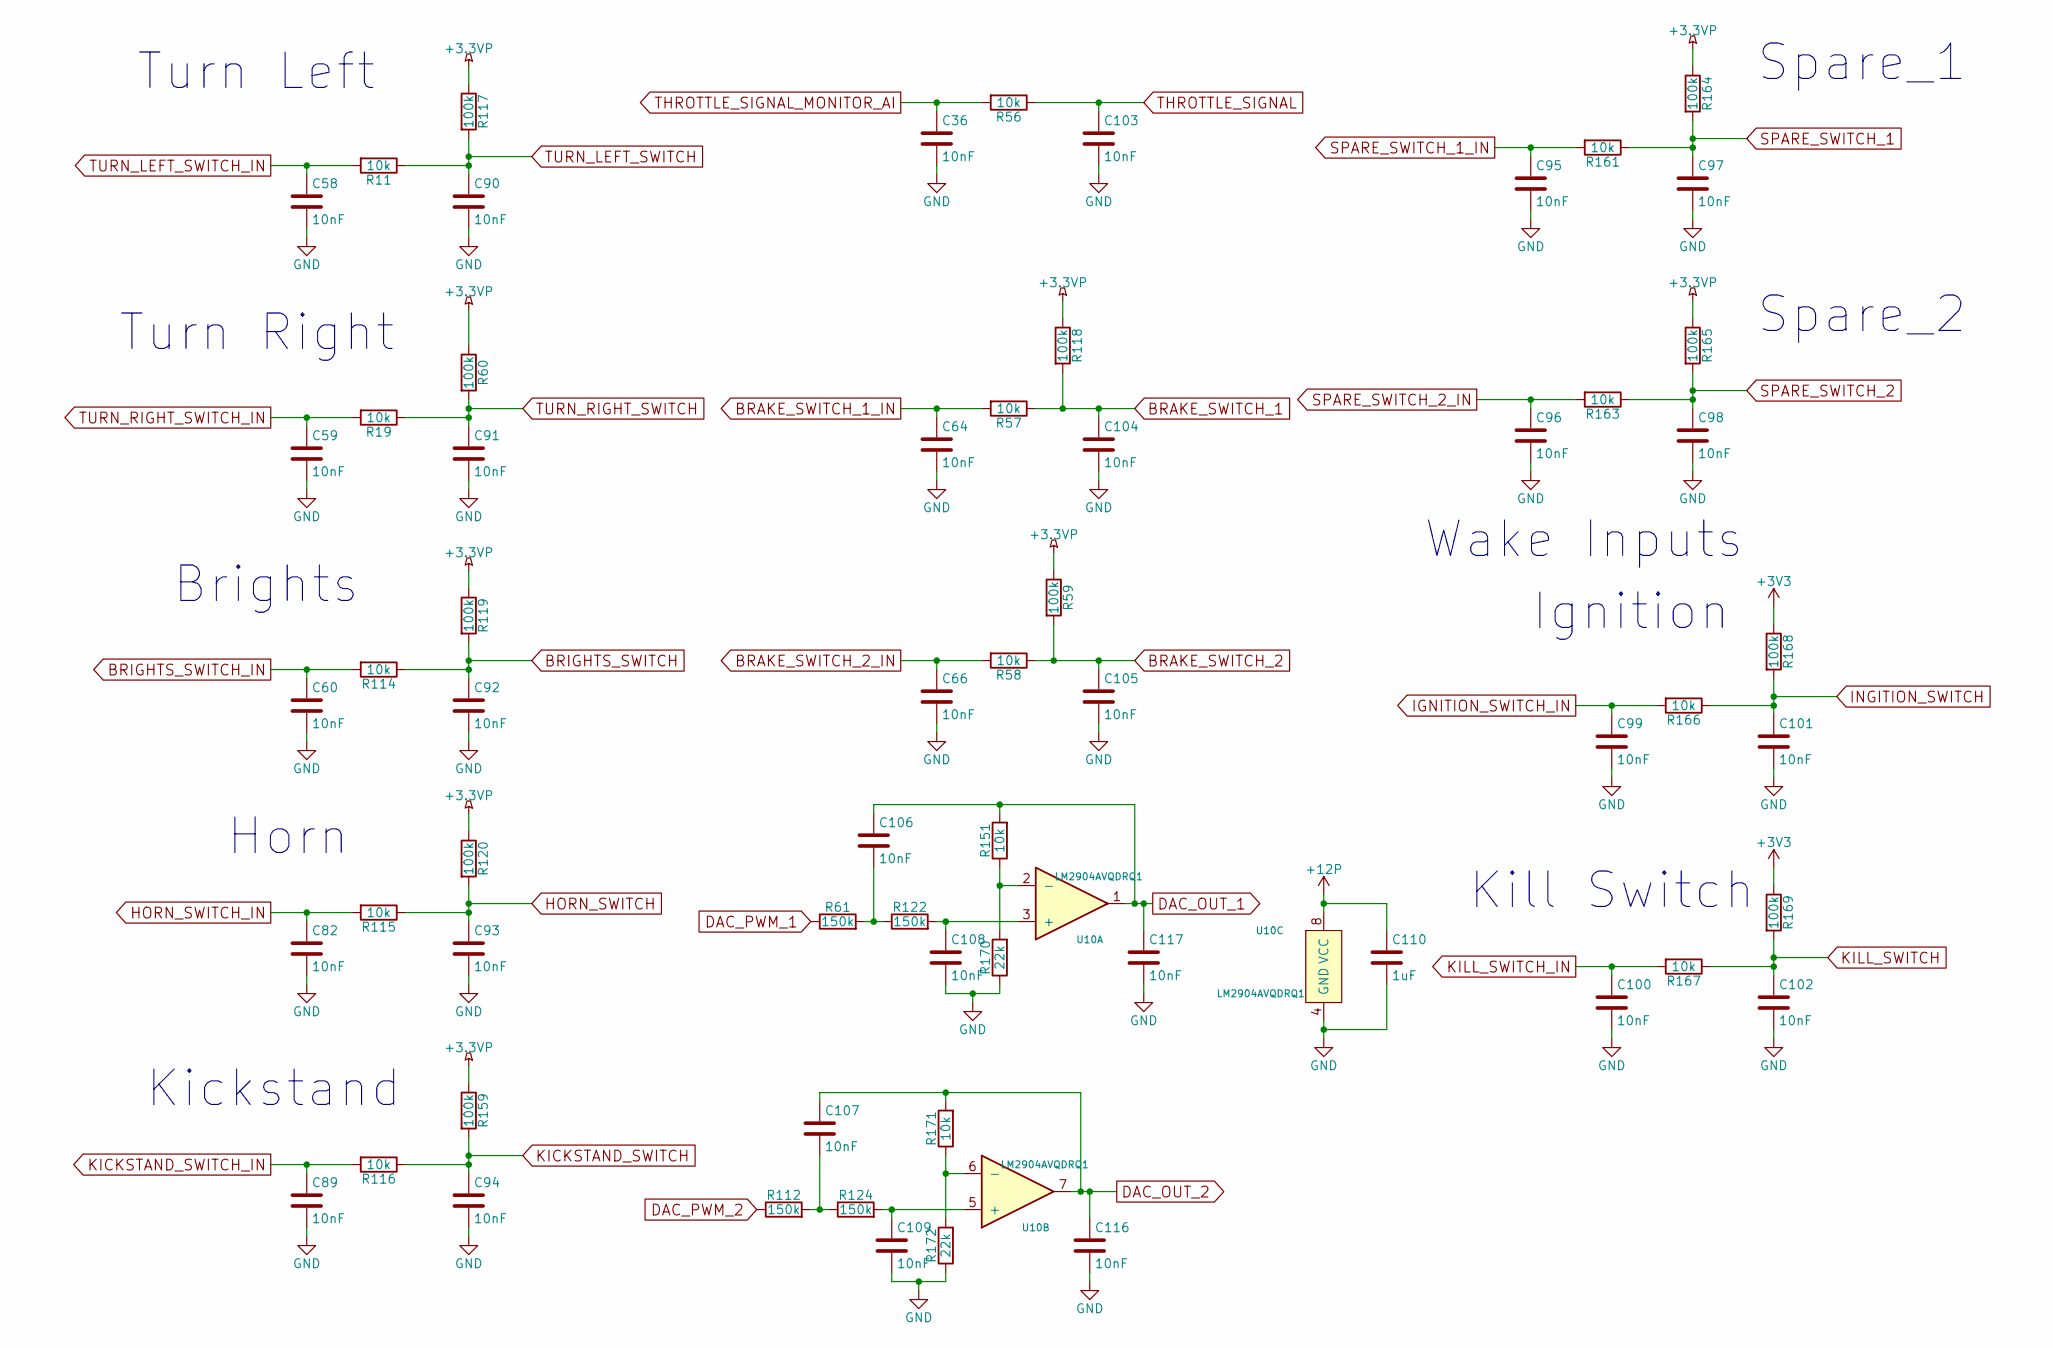
[picture p16: schematic Inputs.sch]

Parts:
C36, C58, C59, C60, C64, C66, C82, C89, C90, C91, C92, C93, C94, C95, C96, C97, C98, C99, C100, C101, C102, C103, C104, C105, C106, C107, C108, C109, C116, C117: 10nF; C_0603; MPN CGA3E2X7R1H103K080AA
C110: 1uF; C_0805; MPN CGA4J3X7R1H105M125AE
R11, R19, R56, R57, R58, R114, R115, R116, R151, R161, R163, R166, R167, R171: 10k; R_0603; MPN AC0603FR-0710KL
R59, R60, R117, R118, R119, R120, R159, R164, R165, R168, R169: 100k; R_0603; MPN AC0603FR-07100KL
R61, R112, R122, R124: 150k; R_0603; MPN AC0603FR-07150KL
R170, R172: 22k; R_0603; MPN AC0603FR-0722KL
U10: LM2904AVQDRQ1; SOIC-8_3.9x4.9mm_Pitch1.27mm; MPN LM2904AVQDRQ1

Connections:
+3.3VP: R59.1, R60.1, R117.1, R118.1, R119.1, R120.1, R159.1, R164.1, R165.1; also elsewhere on the board
+12P: C110.1, U10.8 (VCC); also elsewhere on the board
BRAKE_SWITCH_1: C104.1, R57.1, R118.2; also elsewhere on the board
BRAKE_SWITCH_1_IN: C64.1, R57.2; also elsewhere on the board
BRAKE_SWITCH_2: C105.1, R58.1, R59.2; also elsewhere on the board
BRAKE_SWITCH_2_IN: C66.1, R58.2; also elsewhere on the board
BRIGHTS_SWITCH: C92.1, R114.1, R119.2; also elsewhere on the board
BRIGHTS_SWITCH_IN: C60.1, R114.2; also elsewhere on the board
DAC_OUT_1: C106.1, C117.1, R151.2, U10.1; also elsewhere on the board
DAC_OUT_2: C107.1, C116.1, R171.2, U10.7; also elsewhere on the board
DAC_PWM_1: R61.1; also elsewhere on the board
DAC_PWM_2: R112.1; also elsewhere on the board
GND: C36.2, C58.2, C59.2, C60.2, C64.2, C66.2, C82.2, C89.2, C90.2, C91.2, C92.2, C93.2, C94.2, C95.2, C96.2, C97.2, C98.2, C99.2, C100.2, C101.2, C102.2, C103.2, C104.2, C105.2, C108.2, C109.2, C110.2, C116.2, C117.2, R170.1, R172.1, U10.4 (GND); also elsewhere on the board
HORN_SWITCH: C93.1, R115.1, R120.2; also elsewhere on the board
HORN_SWITCH_IN: C82.1, R115.2; also elsewhere on the board
IGNITION_SWITCH_IN: C99.1, R166.2; also elsewhere on the board
INGITION_SWITCH: C101.1, R166.1, R168.2; also elsewhere on the board
KICKSTAND_SWITCH: C94.1, R116.1, R159.2; also elsewhere on the board
KICKSTAND_SWITCH_IN: C89.1, R116.2; also elsewhere on the board
KILL_SWITCH: C102.1, R167.1, R169.2; also elsewhere on the board
KILL_SWITCH_IN: C100.1, R167.2; also elsewhere on the board
unnamed: C106.2, R61.2, R122.1
unnamed: C107.2, R112.2, R124.1
unnamed: C108.1, R122.2, U10.3 (+)
unnamed: C109.1, R124.2, U10.5 (+)
unnamed: R151.1, R170.2, U10.2 (-)
unnamed: R171.1, R172.2, U10.6 (-)
SPARE_SWITCH_1: C97.1, R161.1, R164.2; also elsewhere on the board
SPARE_SWITCH_1_IN: C95.1, R161.2; also elsewhere on the board
SPARE_SWITCH_2: C98.1, R163.1, R165.2; also elsewhere on the board
SPARE_SWITCH_2_IN: C96.1, R163.2; also elsewhere on the board
THROTTLE_SIGNAL: C103.1, R56.1; also elsewhere on the board
THROTTLE_SIGNAL_MONITOR_AI: C36.1, R56.2; also elsewhere on the board
TURN_LEFT_SWITCH: C90.1, R11.1, R117.2; also elsewhere on the board
TURN_LEFT_SWITCH_IN: C58.1, R11.2; also elsewhere on the board
TURN_RIGHT_SWITCH: C91.1, R19.1, R60.2; also elsewhere on the board
TURN_RIGHT_SWITCH_IN: C59.1, R19.2; also elsewhere on the board

Notes on the sheet:
Wake Inputs
Ignition
Kill Switch
Turn Left
Turn Right
Brights
Horn
Kickstand
Spare_1
Spare_2

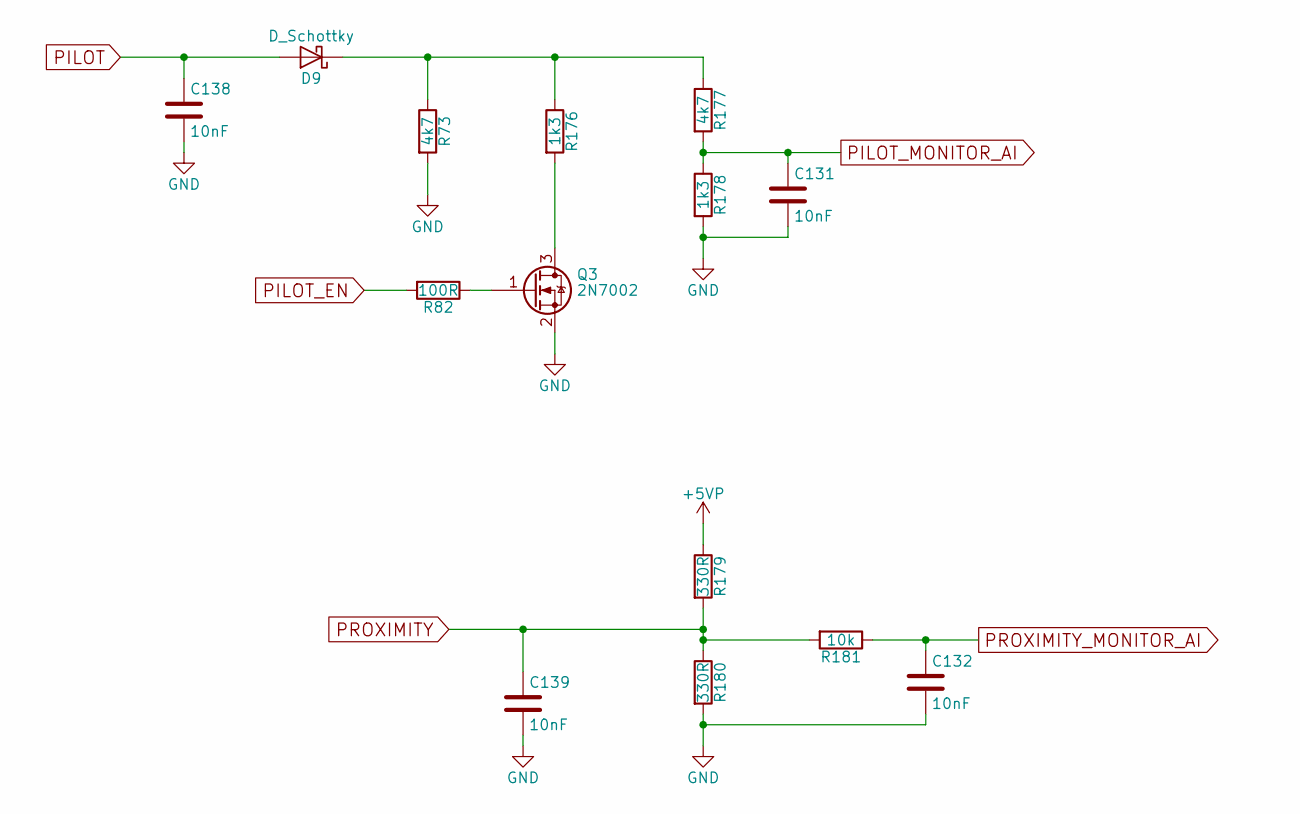
[picture p17: schematic J1772.sch]

Parts:
C131, C132, C138, C139: 10nF; C_0603; MPN CGA3E2X7R1H103K080AA
D9: D_Schottky; D_SOD-123; MPN PMEG6020AELRX
Q3: 2N7002; SOT-23; MPN 2N7002P,215
R73, R177: 4k7; R_0603
R82: 100R; R_0603; MPN AC0603FR-07100RL
R176: 1k3; R_0603; MPN RMCF0603FT1K30
R178: 1k3; R_0603
R179, R180: 330R; R_0603; MPN AC0603FR-07330RL
R181: 10k; R_0603; MPN AC0603FR-0710KL

Connections:
+5VP: R179.1; also elsewhere on the board
GND: C131.2, C132.2, C138.2, C139.2, Q3.2 (S), R73.2, R178.2, R180.2; also elsewhere on the board
unnamed: D9.1 (K), R73.1, R176.1, R177.1
unnamed: Q3.1 (G), R82.1
unnamed: Q3.3 (D), R176.2
PILOT: C138.1, D9.2 (A); also elsewhere on the board
PILOT_EN: R82.2; also elsewhere on the board
PILOT_MONITOR_AI: C131.1, R177.2, R178.1; also elsewhere on the board
PROXIMITY: C139.1, R179.2, R180.1, R181.2; also elsewhere on the board
PROXIMITY_MONITOR_AI: C132.1, R181.1; also elsewhere on the board

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
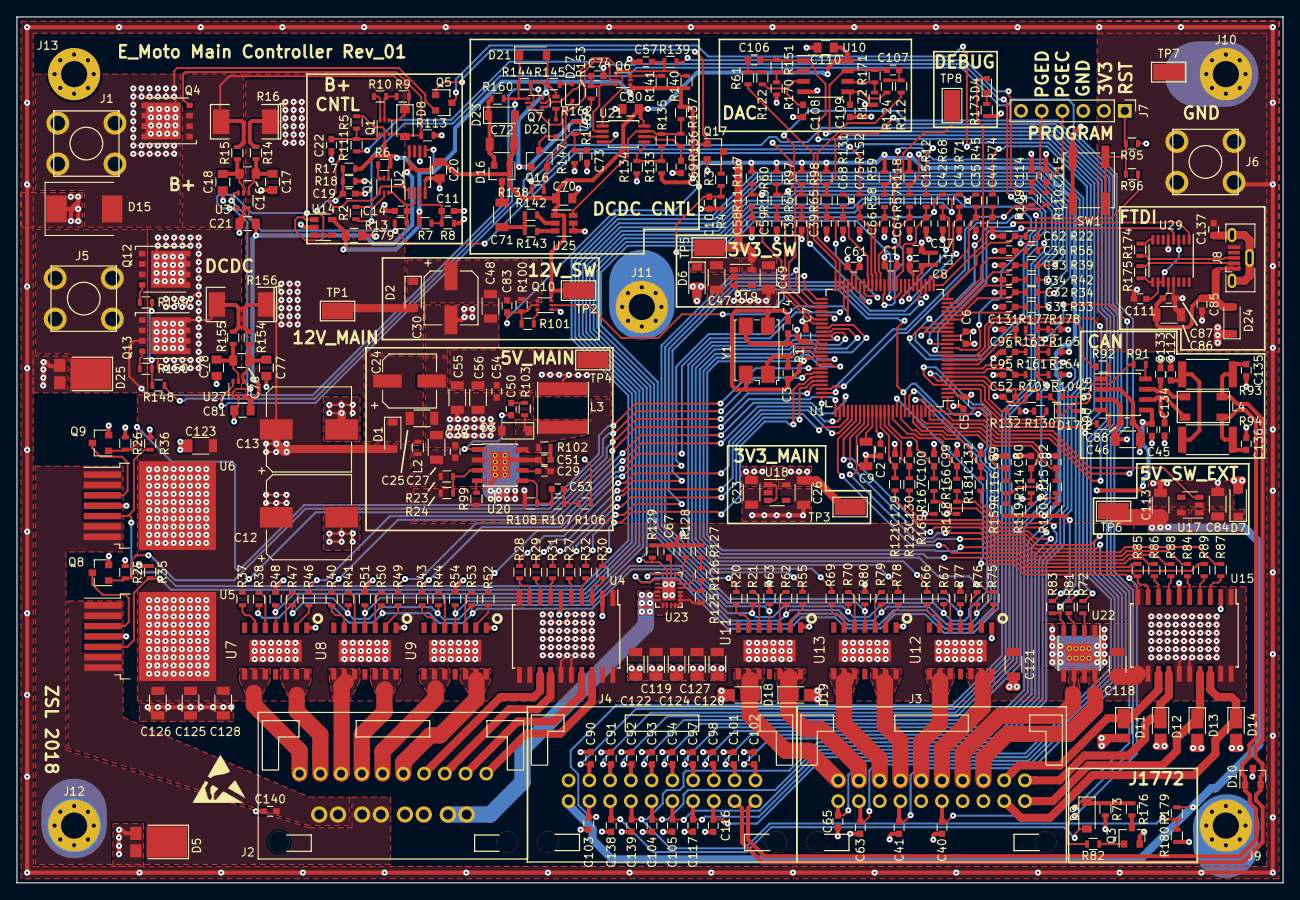
[picture p18: board BodyController_01.kicad_pcb from above]

Board: 4 copper layers, 155.0 x 106.0 mm, 415 parts (0 on the bottom side), 284 nets.
