Voltworks-Garage/Hardware/PCBAs/BMS/BMS_01/BMS_01.kicad_pcb

## KiCad design PCBAs/BMS/BMS_01/BMS_01.kicad_pcb (2025-06-25)

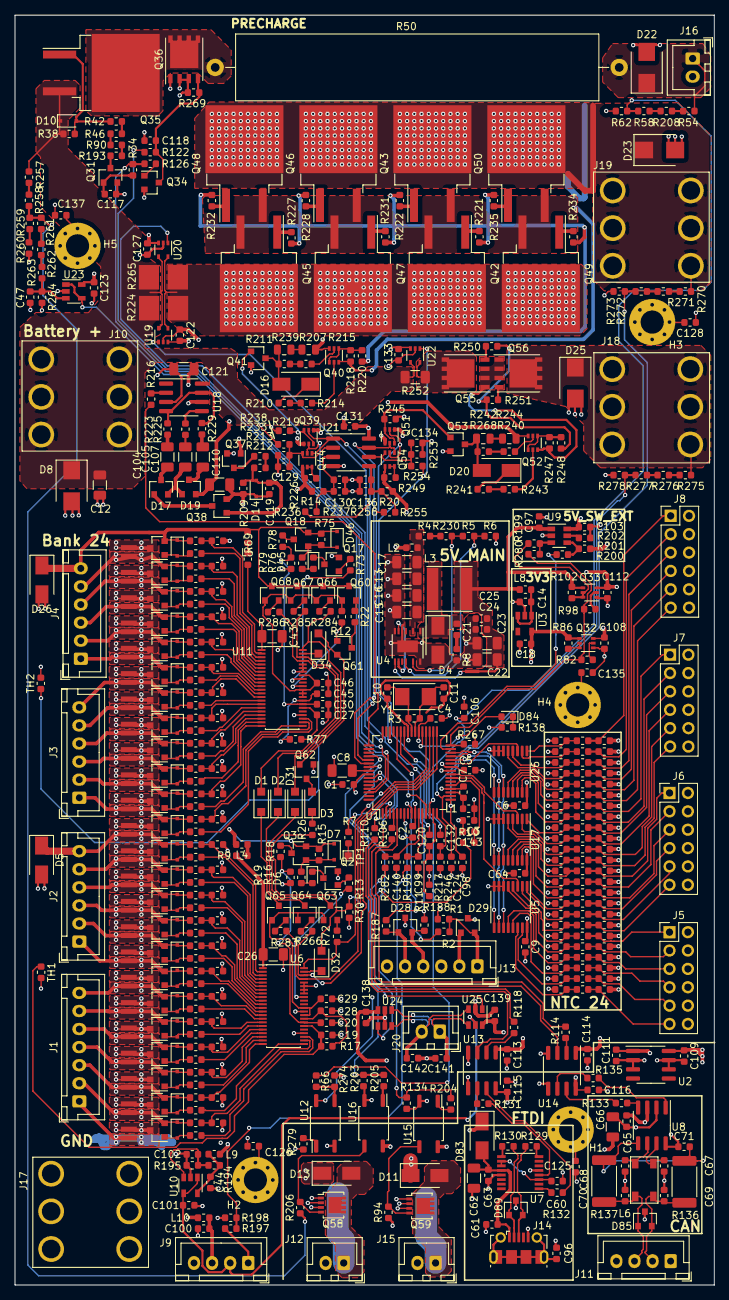
[picture p19: board BMS_01.kicad_pcb from above]

Board: 4 copper layers, 96.7 x 175.7 mm, 605 parts (0 on the bottom side), 414 nets.

Parts:
C1, C2, C3, C4, C5, C6, C7, C9, C14, C18, C19, C20, C24, C27, C30, C31, C32, C33, C34, C35, C36, C37, C38, C39, C40, C41, C42, C44, C47, C48, C49, C50, C51, C52, C53, C54, C55, C56, C57, C58, C59, C60, C63, C64, C96, C97, C99, C101, C102, C103, C108, C109, C111, C112, C113, C114, C115, C116, C119, C123, C130, C131, C136, C138, C139, C140, C141, C142, C143: 100nF; C_0603_1608Metric
C8, C22, C23: 10uF; C_1206_3216Metric
C10, C11, C21, C67, C68, C69, C70: 18pF; C_0603_1608Metric
C12, C13, C15, C16, C17, C26, C43, C104, C105, C107: 100nF; C_1206_3216Metric
C25, C61, C65, C71, C72, C73, C74, C75, C76, C77, C78, C79, C80, C81, C82, C83, C84, C85, C86, C87, C88, C89, C90, C91, C92, C93, C94, C95, C98, C106, C117, C118, C120, C122, C124, C125, C126, C127, C128, C132, C133, C135, C137: 10nF; C_0603_1608Metric
C28, C29, C45, C46, C100: 1uF; C_0603_1608Metric
C62, C66, C110, C121: 4u7; C_1206_3216Metric
C129, C134: 1nF; C_0603_1608Metric
D1, D2, D3, D31, D32, D34: D_Schottky; D_SOD-123F
D4, D11, D13, D16, D20, D83: D_Schottky; D_SMA
D5, D26: D_TVS; D_SMA
D6, D45, D84: D_LED; D_0603_1608Metric
D7, D9, D10, D12, D14, D15, D18, D21, D24, D27, D30, D33, D36, D39, D42, D46, D48, D51, D54, D57, D60, D63, D66, D69, D72, D75, D78, D81: 12V; D_SOD-323F
D8, D22, D23, D25: D_TVS; D_SMB
D17, D19: D_Schottky_x2_Serial_AKC; SOT-23
D28, D29, D85, D89: D_Schottky_x2_ACom_AKK; D_SOT-23_ANK
H1, H2, H3, H4, H5: MountingHole_Pad; MountingHole_3.2mm_M3_Pad_Via
J1: Conn_01x07; JST_XH_B7B-XH-A_1x07_P2.50mm_Vertical
J2, J3, J4, J13: Conn_01x06; JST_XH_B6B-XH-A_1x06_P2.50mm_Vertical
J5, J6, J7, J8: Conn_02x06_Odd_Even; PinHeader_2x06_P2.54mm_Vertical
J9, J11: Conn_01x04; JST_XH_B4B-XH-A_1x04_P2.50mm_Vertical
J10, J17, J18, J19: 7807
J12, J15, J16, J20: Conn_01x02; JST_XH_B2B-XH-A_1x02_P2.50mm_Vertical
J14: USB_B_Micro; USB_Micro-B_Molex-105017-0001
L1, L2, L4, L5, L8, L9, L10: Ferrite_Bead; L_0603_1608Metric
L3: 220u; Inductor_Taiyo-Yuden_NR-60xx
L6: EMI_Filter_CommonMode; ACT45B
NT1: Net-Tie_2; Net_Tie-0.5mm
Q2, Q17, Q37, Q41, Q53, Q61: Q_NMOS_GSD; SOT-23
Q3, Q4, Q5, Q6, Q7, Q8, Q9, Q10, Q11, Q12, Q13, Q14, Q15, Q18, Q19, Q20, Q21, Q22, Q23, Q24, Q25, Q26, Q27, Q28, Q29, Q30, Q38: Q_PMOS_GSD; SOT-23
Q31, Q34, Q60, Q63, Q64, Q65, Q66, Q67, Q68: Q_NPN_BEC; SOT-23
Q32, Q33, Q44, Q54: Q_DUAL_NMOS_PMOS; SOT-363_SC-70-6
Q35: Q_PMOS_GDS; TO-263-2
Q36, Q55, Q56: TPH3300CNH,L1Q; PowerPAK_SO-8_Single
Q39, Q51: Q_DUAL_PMOS_S1G1D2S2G2D1; SOT-363_SC-70-6
Q40, Q52: Q_DUAL_NPN_PNP_E1B1C2E2B2C1; SOT-363_SC-70-6
Q42, Q43, Q45, Q46, Q47, Q48, Q49, Q50: NTB5D0N15MC; TO-263-2
Q58, Q59: RQ3G100GNTB; LFPAK33
Q62: Q_PNP_BEC; SOT-23
R1, R2, R10, R15, R34, R66, R75, R86, R94, R102, R122, R126, R134, R139, R140, R141, R142, R143, R144, R145, R146, R147, R148, R149, R150, R151, R152, R153, R154, R155, R156, R157, R158, R159, R160, R161, R162, R163, R164, R165, R166, R167, R168, R169, R170, R171, R172, R173, R174, R175, R176, R177, R178, R179, R180, R181, R182, R183, R184, R185, R186, R194, R195, R196, R197, R200, R201, R203, R206, R217, R219, R226, R233, R237, R238, R245, R246, R249, R253, R254, R255, R267, R274, R279, R280, R282: 10k0; R_0603_1608Metric
R3, R4, R12, R14, R20, R54, R58, R208, R264, R270, R271, R272, R275, R276, R277: 1M; R_0603_1608Metric
R5, R16, R76: 32k0; R_0603_1608Metric
R6: 13k0; R_0603_1608Metric
R7, R13, R23, R26, R27, R31, R35, R39, R43, R47, R51, R55, R59, R63, R67, R73, R82, R83, R87, R91, R95, R98, R99, R103, R106, R107, R110, R111, R114, R115, R118, R119, R123, R127, R131, R132, R133, R135, R138, R187, R188, R199, R204, R205, R216: 100R; R_0603_1608Metric
R8, R202, R220, R221, R222, R223, R225, R227, R228, R229, R231, R232, R234, R235, R248, R250, R251: 3R3; R_0603_1608Metric
R9, R69, R129, R130: 20R0; R_0603_1608Metric
R11, R198, R236, R256: 19k6; R_0603_1608Metric
R17, R38, R42, R46, R62, R77, R90, R193, R209, R212, R269, R273, R278: 100k; R_0603_1608Metric
R18, R78, R213, R218, R230, R247: 499k; R_0603_1608Metric
R19, R79: 26k1 0.1%; R_0603_1608Metric
R21, R25, R29, R33, R37, R41, R45, R49, R53, R57, R61, R65, R81, R85, R89, R93, R97, R101, R105, R109, R113, R117, R121, R125: 15R0; Resistor_SMD_0805_Wide
R22: 1k8; R_0603_1608Metric
R24, R28, R32, R36, R40, R44, R48, R52, R56, R60, R64, R68, R84, R88, R92, R96, R100, R104, R108, R112, R116, R120, R124, R128: 3k3; R_0603_1608Metric
R30, R72, R266, R283, R284, R285, R286: 2k2; R_0603_1608Metric
R50: 100R; R_Axial_Power_L50.0mm_W9.0mm_P55.88mm
R136, R137: 60R; R_2512_6332Metric
R207, R239, R240, R268: 51k0; R_0805_2012Metric
R210, R211, R214, R215, R241, R242, R243, R244: 1k; R_0603_1608Metric
R224, R265: R001; R_2512_6332Metric_PMR100
R252: R001; R_1206_3216Metric
R257, R258, R259, R260, R261, R262, R263: 10M; R_0603_1608Metric
TH1, TH2: Thermistor_NTC; R_0603_1608Metric
TP1: TestPoint; TestPoint_Pad_1.0x1.0mm
U1: PIC33EP256MC506; TQFP-64_10x10mm_P0.5mm
U2: LM2931-5.0_SO8; SOIC-8_3.9x4.9mm_P1.27mm
U3: TPS73633DBV; SOT-23-5
U4: LTC3638; Linear_MSOP-12-16-1EP_3x4mm_P0.5mm
U5, U17, U26: CD4051B; TSSOP-16_4.4x5mm_P0.65mm
U6, U11: LTC6802-2; TSSOP-44_4.4x11.2mm_P0.5mm
U7: FT230XS; SSOP-16_3.9x4.9mm_P0.635mm
U8: MCP2562-E-SN; SOIC-8_3.9x4.9mm_P1.27mm
U9: TPS2551-Q1; SOT-23-6
U10, U23: OPA320-Q1; SOT-23-5
U12, U15, U16: TLX9185A(GBTPL,F; SO-4_4.4x3.9mm_P2.54mm
U13, U14: ADUM1281ARZ-RL7; SOIC-8_3.9x4.9mm_P1.27mm
U18: FAN3216TMX-F085; SOIC-8_3.9x4.9mm_P1.27mm
U19: INA290A3; SOT-353_SC-70-5
U20: INA290A4; SOT-353_SC-70-5
U21: LMV393; SOIC-8_3.9x4.9mm_P1.27mm
U22: INA290; SOT-353_SC-70-5
U24, U25: INA181; SOT-23-6
Y1: 8MHz; Crystal_SMD_5032-2Pin_5.0x3.2mm

Connections:
5V_SW_nFAULT: R200.2, U1.31
12V_POWER: C109.1, D11.1, D13.1, J11.1, J12.2, J15.2, R279.2, U2.8
12V_POWER_STATUS: R66.1, U1.42
+3.3VA: C108.1, C113.1, C114.1, C123.1, C138.1, C139.1, L9.2, Q32.3, Q37.1, Q39.1, Q39.4, Q44.4, Q51.1, Q51.4, Q54.4, R140.1, R142.1, R144.1, R146.1, R148.1, R150.1, R152.1, R154.1, R156.1, R158.1, R160.1, R162.1, R164.1, R166.1, R168.1, R170.1, R172.1, R174.1, R176.1, R178.1, R180.1, R182.1, R184.1, R186.1, R201.1, R226.2, R236.1, R249.2, R255.1, U13.1, U14.1, U23.5, U24.6, U25.6
+3V3: C1.1, C2.1, C3.1, C4.1, C5.1, C18.1, D29.2, J13.2, L1.2, Q32.4, R1.1, R86.2, U1.10, U1.26, U1.38, U1.57, U3.5, U12.4
+5V: C22.1, C23.1, C24.1, C25.1, C97.1, L3.2, L8.2, NT1.2, Q33.4, R102.2, U9.1
+5VA: C6.1, C9.1, C64.1, C112.1, C121.2, C122.1, C127.1, C131.1, C133.1, Q33.3, U5.16, U17.16, U18.6, U19.3, U20.3, U21.8, U22.3, U26.16
+5VL: C65.1, C66.2, C111.1, C115.1, C116.1, D83.1, U2.1, U8.3, U13.8, U14.8, U15.4, U16.4
+5VP: C103.1, L10.2, U9.6
+BATT: C12.1, C110.1, C119.1, D8.1, D10.1, D14.1, J10.1, L2.2, Q35.3, Q38.2, R38.2, R209.1, R224.1, R252.1, R257.1, R265.1, U19.5, U20.4, U22.4
/TopLevel/ChargerAndDCDC/HV_CHARGEPUMP_POWER: C110.2, D19.2, Q40.6, Q52.6, R207.1, R240.1
/TopLevel/ChargerAndDCDC/HV_DCDC_gate_r: Q52.1, Q52.4, R247.1, R248.1
/TopLevel/ChargerAndDCDC/HV_charge_pump_input: D17.1, Q38.3
/TopLevel/ChargerAndDCDC/HV_cp_s1: C104.1, D17.3
/TopLevel/ChargerAndDCDC/HV_cp_s2: C105.1, D17.2, D19.1
/TopLevel/ChargerAndDCDC/HV_cp_s3: C107.1, D19.3
/TopLevel/ChargerAndDCDC/HV_dcdc_gate: R248.2, R250.1, R251.1
/TopLevel/ChargerAndDCDC/HV_dcdc_shunt: Q55.5, R252.2, U22.5
/TopLevel/ChargerAndDCDC/HV_dcdc_signal: D20.2, Q53.3, R242.1, R268.2
/TopLevel/ChargerAndDCDC/HV_dcdc_source: Q52.3, Q55.1, Q55.2, Q55.3, Q56.1, Q56.2, Q56.3, R247.2
/TopLevel/ChargerAndDCDC/HV_ev_g: R220.2, R221.1, R222.1, R227.1, R228.1, R231.1, R232.1, R234.1, R235.1
/TopLevel/ChargerAndDCDC/HV_ev_g_R: Q40.1, Q40.4, R218.1, R220.1
/TopLevel/ChargerAndDCDC/HV_ev_shunt: Q42.2, Q45.2, Q47.2, Q49.2, R224.2, R265.2, U19.4, U20.5
/TopLevel/ChargerAndDCDC/HV_ev_signal: D16.2, Q41.3, R211.1, R239.2
/TopLevel/ChargerAndDCDC/HV_ev_source: Q40.3, Q42.3, Q43.3, Q45.3, Q46.3, Q47.3, Q48.3, Q49.3, Q50.3, R218.2
/TopLevel/ChargerAndDCDC/dcdc_i: R246.2, R254.1, U22.1
/TopLevel/ChargerAndDCDC/outa: R223.1, R229.2, U18.4, U18.7
/TopLevel/Communications/CAN_FILT_N: C68.2, L6.3, U8.6
/TopLevel/Communications/CAN_FILT_P: C67.2, L6.1, U8.7
/TopLevel/Contactor/HV_precharge_gate: D10.2, Q35.1, R38.1, R42.2
/TopLevel/Contactor/HV_precharge_switch: Q35.2, Q36.5, R50.2
/TopLevel/PowerRails/5V_N_SW_EN: Q33.5, Q33.6, R102.1, R199.2
/TopLevel/PowerRails/FB_5V: NT1.1, U4.9
/TopLevel/PowerRails/HV_VBATT_FILT_5V_IN: C13.1, C15.1, C16.1, C17.1, L2.1, R4.1, U4.3
/TopLevel/PowerRails/SWITCH_NODE_5V: C21.1, D4.1, L3.1, U4.1
/TopLevel/Stack_1/Bank_1/C: C34.1, R35.1, U6.24
/TopLevel/Stack_1/Bank_1/S: R36.1, U6.25
/TopLevel/Stack_1/Bank_2/C: C33.1, R31.1, U6.22
/TopLevel/Stack_1/Bank_2/S: R32.1, U6.23
/TopLevel/Stack_1/Bank_3/C: C32.1, R27.1, U6.20
/TopLevel/Stack_1/Bank_3/S: R28.1, U6.21
/TopLevel/Stack_1/Bank_4/C: C31.1, R23.1, U6.18
/TopLevel/Stack_1/Bank_4/S: R24.1, U6.19
/TopLevel/Stack_1/Bank_5/C: C35.1, R39.1, U6.16
/TopLevel/Stack_1/Bank_5/S: R40.1, U6.17
/TopLevel/Stack_1/Bank_6/C: C36.1, R43.1, U6.14
/TopLevel/Stack_1/Bank_6/S: R44.1, U6.15
/TopLevel/Stack_1/Bank_7/C: C37.1, R47.1, U6.12
/TopLevel/Stack_1/Bank_7/S: R48.1, U6.13
/TopLevel/Stack_1/Bank_8/C: C38.1, R51.1, U6.10
/TopLevel/Stack_1/Bank_8/S: R52.1, U6.11
/TopLevel/Stack_1/Bank_9/C: C39.1, R55.1, U6.8
/TopLevel/Stack_1/Bank_9/S: R56.1, U6.9
/TopLevel/Stack_1/Bank_10/C: C40.1, R59.1, U6.6
/TopLevel/Stack_1/Bank_10/S: R60.1, U6.7
/TopLevel/Stack_1/Bank_11/C: C41.1, R63.1, U6.4
/TopLevel/Stack_1/Bank_11/S: R64.1, U6.5
/TopLevel/Stack_1/Bank_12/C: C42.1, R67.1, U6.2
/TopLevel/Stack_1/Bank_12/S: R68.1, U6.3
/TopLevel/Stack_1/CSB_daisy: D31.1, Q63.3
/TopLevel/Stack_1/SCK_daisy: D1.1, Q65.3
/TopLevel/Stack_1/SDI_daisy: D2.1, Q64.3
/TopLevel/Stack_1/Vref: C28.1, R17.2, U6.30
/TopLevel/Stack_1/Vreg: C29.1, Q63.1, Q64.1, Q65.1, U6.31, U6.33
/TopLevel/Stack_2/Bank_1/C: C51.1, R95.1, U11.24
/TopLevel/Stack_2/Bank_1/S: R96.1, U11.25
/TopLevel/Stack_2/Bank_2/C: C50.1, R91.1, U11.22
/TopLevel/Stack_2/Bank_2/S: R92.1, U11.23
/TopLevel/Stack_2/Bank_3/C: C49.1, R87.1, U11.20
/TopLevel/Stack_2/Bank_3/S: R88.1, U11.21
/TopLevel/Stack_2/Bank_4/C: C48.1, R83.1, U11.18
/TopLevel/Stack_2/Bank_4/S: R84.1, U11.19
/TopLevel/Stack_2/Bank_5/C: C52.1, R99.1, U11.16
/TopLevel/Stack_2/Bank_5/S: R100.1, U11.17
/TopLevel/Stack_2/Bank_6/C: C53.1, R103.1, U11.14
/TopLevel/Stack_2/Bank_6/S: R104.1, U11.15
/TopLevel/Stack_2/Bank_7/C: C54.1, R107.1, U11.12
/TopLevel/Stack_2/Bank_7/S: R108.1, U11.13
/TopLevel/Stack_2/Bank_8/C: C55.1, R111.1, U11.10
/TopLevel/Stack_2/Bank_8/S: R112.1, U11.11
/TopLevel/Stack_2/Bank_9/C: C56.1, R115.1, U11.8
/TopLevel/Stack_2/Bank_9/S: R116.1, U11.9
/TopLevel/Stack_2/Bank_10/C: C57.1, R119.1, U11.6
/TopLevel/Stack_2/Bank_10/S: R120.1, U11.7
/TopLevel/Stack_2/Bank_11/C: C58.1, R123.1, U11.4
/TopLevel/Stack_2/Bank_11/S: R124.1, U11.5
/TopLevel/Stack_2/Bank_12/C: C59.1, R127.1, U11.2
/TopLevel/Stack_2/Bank_12/S: R128.1, U11.3
/TopLevel/Stack_2/CSBI: D31.2, R284.2, U11.44
/TopLevel/Stack_2/SCKL: D1.2, R286.2, U11.41
/TopLevel/Stack_2/SDI: D2.2, R285.2, U11.42
/TopLevel/Stack_2/SDO: D34.2, Q61.2, Q62.2
/TopLevel/Stack_2/Vref: C45.1, R77.2, U11.30
/TopLevel/vreg_s2: C46.1, Q60.1, Q66.1, Q67.1, Q68.1, R12.1, U11.31, U11.32, U11.33, U11.37
/TopLevel/wd_s2: Q61.1, R12.2, U11.34
BANK_01: D18.1, J1.2, Q7.2, R29.2, R35.2
BANK_02: D15.1, J1.3, Q6.2, R25.2, R31.2
BANK_03: D12.1, J1.4, Q5.2, R21.2, R27.2
BANK_04: D9.1, J1.5, Q4.2, R23.2, R37.2
BANK_05: D21.1, J1.6, Q8.2, R39.2, R41.2
BANK_06: D24.1, J1.7, Q9.2, R43.2, R45.2
BANK_07: D27.1, J2.1, Q10.2, R47.2, R49.2
BANK_08: D30.1, J2.2, Q11.2, R51.2, R53.2
BANK_09: D33.1, J2.3, Q12.2, R55.2, R57.2
BANK_10: D36.1, J2.4, Q13.2, R59.2, R61.2
BANK_11: D39.1, J2.5, Q14.2, R63.2, R65.2
BANK_12: C27.2, C30.2, C43.1, C45.2, C46.2, C48.2, C49.2, C50.2, C51.2, C52.2, C53.2, C54.2, C55.2, C56.2, C57.2, C58.2, C59.2, D5.1, D7.1, D26.2, D42.1, J2.6, L4.2, Q3.2, Q15.2, Q17.2, Q62.1, R15.1, R67.2, R79.2, R93.2, TH2.2, U11.26, U11.38, U11.39, U11.40
BANK_13: D57.1, J3.1, Q22.2, R89.2, R95.2
BANK_14: D54.1, J3.2, Q21.2, R85.2, R91.2
BANK_15: D51.1, J3.3, Q20.2, R81.2, R87.2
BANK_16: D48.1, J3.4, Q19.2, R83.2, R97.2
BANK_17: D60.1, J3.5, Q23.2, R99.2, R101.2
BANK_18: D63.1, J3.6, Q24.2, R103.2, R105.2
BANK_19: D66.1, J4.1, Q25.2, R107.2, R109.2
BANK_20: D69.1, J4.2, Q26.2, R111.2, R113.2
BANK_21: D72.1, J4.3, Q27.2, R115.2, R117.2
BANK_22: D75.1, J4.4, Q28.2, R119.2, R121.2
BANK_23: D78.1, J4.5, Q29.2, R123.2, R125.2
BANK_24: D26.1, D46.1, D81.1, J4.6, L5.2, Q18.2, Q30.2, Q60.3, Q66.3, Q67.3, Q68.3, R75.1, R127.2
CAN_N: C70.2, D85.2, J11.3, L6.4, R137.1
CAN_P: C69.2, D85.3, J11.2, L6.2, R136.2
CAN_RX: R114.2, U1.5
CAN_RX_LV: R133.2, U14.7
CAN_TX: R106.2, U1.4
CAN_TX_LV: R135.2, U14.6
CHARGE_PUMP_PWM: R216.1, U1.49
CONTACTOR_PWM_1: R134.2, R204.2, U1.55
CONTACTOR_PWM_1_OUT: D11.2, J15.1, Q59.5
CONTACTOR_PWM_2: R203.2, R205.2, U1.52
CONTACTOR_PWM_2_OUT: D13.2, J12.1, Q58.5
DCDC_ENABLE: Q51.2, Q54.2, U1.46
DCDC_OUTPUT_CURRENT_AI: C132.1, R246.1, U1.16
DCDC_OUTPUT_VOLTAGE_AI: C124.1, R277.1, R278.2, U1.18
DCDC_~FAULT: Q51.5, Q54.1, R20.1, U1.54, U21.7
DEBUG_LED: D84.2, U1.37
DEBUG_PIN: R7.1, U1.2
DISCHARGE_EN: R122.2, U1.61
EV_CHARGER_CURRENT_AI: C120.1, R11.1, R217.1, U1.15
EV_CHARGER_ENABLE: Q39.2, Q44.2, U1.48
EV_CHARGER_VOLTAGE_AI: C98.1, R272.1, R273.2, U1.17
EV_CHARGER_~FAULT: Q39.5, Q44.1, R14.1, U1.53, U21.1
GND: C1.2, C2.2, C3.2, C4.2, C5.2, C6.2, C7.2, C8.2, C9.2, C10.2, C11.2, C12.2, C13.2, C14.2, C15.2, C16.2, C17.2, C18.2, C19.2, C20.2, C22.2, C23.2, C24.2, C25.2, C26.1, C28.2, C29.2, C31.2, C32.2, C33.2, C34.2, C35.2, C36.2, C37.2, C38.2, C39.2, C40.2, C41.2, C42.2, C44.2, C47.2, C64.2, C72.2, C73.2, C74.2, C75.2, C76.2, C77.2, C78.2, C79.2, C80.2, C81.2, C82.2, C83.2, C84.2, C85.2, C86.2, C87.2, C88.2, C89.2, C90.2, C91.2, C92.2, C93.2, C94.2, C95.2, C97.2, C98.2, C99.2, C100.2, C101.2, C102.2, C103.2, C106.2, C108.2, C112.2, C113.2, C114.2, C117.2, C118.2, C120.2, C121.1, C122.2, C123.2, C124.2, C126.2, C127.2, C128.2, C129.2, C130.2, C131.2, C132.2, C133.2, C134.2, C135.2, C136.2, C137.2, C138.2, C139.2, C140.2, C141.2, C142.2, C143.2, D4.2, D5.2, D8.2, D22.2, D23.2, D25.2, D28.1, D29.1, J1.1, J5.2, J5.4, J5.6, J5.8, J5.10, J5.12, J6.2, J6.4, J6.6, J6.8, J6.10, J6.12, J7.2, J7.4, J7.6, J7.8, J7.10, J7.12, J8.2, J8.4, J8.6, J8.8, J8.10, J8.12, J9.4, J13.3, J17.1, Q2.2, Q31.2, Q32.1, Q33.1, Q34.2, Q36.1, Q36.2, Q36.3, Q37.2, Q41.2, Q53.2, R6.2, R8.2, R11.2, R19.2, R30.2, R33.2, R62.1, R134.1, R138.1, R195.2, R198.1, R202.2, R203.1, R219.1, R233.1, R237.2, R245.1, R253.1, R256.2, R260.2, R264.2, R267.1, R269.1, R273.1, R274.1, R278.1, TH1.2, U1.9, U1.20, U1.25, U1.41, U3.2, U4.6, U4.8, U4.16, U4.17, U5.6, U5.7, U5.8, U6.26, U6.32, U6.37, U6.38, U6.39, U6.40, U9.2, U10.2, U13.4, U14.4, U15.2, U16.2, U17.6, U17.7, U17.8, U18.3, U19.2, U20.2, U21.4, U22.2, U23.2, U24.2, U24.5, U25.2, U26.6, U26.7, U26.8
GND1: C60.2, C61.2, C62.2, C63.2, C65.2, C66.1, C67.1, C68.1, C69.1, C70.1, C71.2, C96.2, C109.2, C111.2, C115.2, C116.2, C125.2, D85.1, D89.1, J11.4, J14.5, Q58.1, Q58.2, Q58.3, Q59.1, Q59.2, Q59.3, R94.1, R206.1, R258.2, R259.1, R261.1, U2.2, U2.3, U2.6, U2.7, U7.5, U7.13, U8.2, U8.8, U12.2, U13.5, U14.5
HIGH_CURRENT_SHUNT_AI: C143.1, R10.2, U1.21
HV_BUS_VOLTAGE_AI: C106.1, R58.1, R62.2, U1.14
HV_DCDC_OUTPUT: D25.1, J18.1, Q56.5, R275.2
HV_EV_CHARGER_INPUT: D23.1, J19.1, Q43.2, Q46.2, Q48.2, Q50.2, R270.2
HV_PRECHARGE_OUT: D22.1, J16.1, R50.1, R54.2
ISOLATION_VOLTAGE_AI: U1.13, U23.1, U23.4
LOW_CURRENT_SHUNT_AI: C140.1, R282.2, U1.11
MUX_1_AI: U1.23, U5.3
MUX_2_AI: U1.24, U17.3
MUX_3_AI: U1.27, U26.3
MUX_A: U1.30, U5.11, U17.11, U26.11
MUX_B: U1.29, U5.10, U17.10, U26.10
MUX_C: U1.28, U5.9, U17.9, U26.9
NTC_1_AI: C72.1, R139.2, U5.14
NTC_1_OUT: J5.11, R139.1, R140.2
NTC_2_AI: C73.1, R141.2, U5.15
NTC_2_OUT: J5.9, R141.1, R142.2
NTC_3_AI: C74.1, R143.2, U5.13
NTC_3_OUT: J5.7, R143.1, R144.2
NTC_4_AI: C75.1, R145.2, U5.12
NTC_4_OUT: J5.5, R145.1, R146.2
NTC_5_AI: C76.1, R147.2, U5.5
NTC_5_OUT: J5.3, R147.1, R148.2
NTC_6_AI: C77.1, R149.2, U5.4
NTC_6_OUT: J5.1, R149.1, R150.2
NTC_7_AI: C78.1, R151.2, U5.2
NTC_7_OUT: J6.11, R151.1, R152.2
NTC_8_AI: C79.1, R153.2, U5.1
NTC_8_OUT: J6.9, R153.1, R154.2
NTC_9_AI: C80.1, R155.2, U17.15
NTC_9_OUT: J6.7, R155.1, R156.2
NTC_10_AI: C81.1, R157.2, U17.14
NTC_10_OUT: J6.5, R157.1, R158.2
NTC_11_AI: C82.1, R159.2, U17.13
NTC_11_OUT: J6.3, R159.1, R160.2
NTC_12_AI: C83.1, R161.2, U17.12
NTC_12_OUT: J6.1, R161.1, R162.2
NTC_13_AI: C84.1, R163.2, U17.5
NTC_13_OUT: J7.11, R163.1, R164.2
NTC_14_AI: C85.1, R165.2, U17.4
NTC_14_OUT: J7.9, R165.1, R166.2
NTC_15_AI: C86.1, R167.2, U17.2
NTC_15_OUT: J7.7, R167.1, R168.2
NTC_16_AI: C87.1, R169.2, U17.1
NTC_16_OUT: J7.5, R169.1, R170.2
NTC_17_AI: C88.1, R171.2, U26.15
NTC_17_OUT: J7.3, R171.1, R172.2
NTC_18_AI: C89.1, R173.2, U26.14
NTC_18_OUT: J7.1, R173.1, R174.2
NTC_19_AI: C90.1, R175.2, U26.13
NTC_19_OUT: J8.11, R175.1, R176.2
NTC_20_AI: C91.1, R177.2, U26.12
NTC_20_OUT: J8.9, R177.1, R178.2
NTC_21_AI: C92.1, R179.2, U26.5
NTC_21_OUT: J8.7, R179.1, R180.2
NTC_22_AI: C93.1, R181.2, U26.4
NTC_22_OUT: J8.5, R181.1, R182.2
NTC_23_AI: C94.1, R183.2, U26.2
NTC_23_OUT: J8.3, R183.1, R184.2
NTC_24_AI: C95.1, R185.2, U26.1
NTC_24_OUT: J8.1, R185.1, R186.2
unnamed: C7.1, L1.1, U1.19
unnamed: C8.1, U1.56
unnamed: C10.1, R3.1, U1.40, Y1.1
unnamed: C11.1, R3.2, U1.39, Y1.2
unnamed: C14.1, L8.1, U3.1, U3.3
unnamed: C19.1, R17.1, TH1.1, U6.28
unnamed: C20.1, R18.2, R19.1, U6.29
unnamed: C21.2, R8.1
unnamed: C26.2, R9.1, U6.1
unnamed: C27.1, R77.1, TH2.1, U11.28
unnamed: C30.1, R78.2, R79.1, U11.29
unnamed: C43.2, R69.1, U11.1
unnamed: C44.1, L9.1, R194.1, U10.5
unnamed: C47.1, R263.2, R264.1, U23.3
unnamed: C60.1, U7.3, U7.10, U7.11
unnamed: C71.1, R136.1, R137.2, U8.5
unnamed: C96.1, J14.6
unnamed: C102.1, R194.2, R195.1, U10.3
unnamed: C104.2, R223.2
unnamed: C105.2, R225.2
unnamed: C107.2, R229.1
unnamed: C117.1, Q31.1, R34.1
unnamed: C118.1, Q34.3, Q36.4, R122.1, R269.2
unnamed: C119.2, D14.2, Q38.1, R209.2, R212.1
unnamed: C125.1, H1.1
unnamed: C126.1, H2.1
unnamed: C128.1, H3.1
unnamed: C129.1, Q44.3, R233.2, R238.2, U21.2
unnamed: C130.1, R14.2, R236.2, R237.1, U21.3
unnamed: C134.1, Q54.3, R253.2, R254.2, U21.6
unnamed: C135.1, H4.1
unnamed: C136.1, R20.2, R255.2, R256.1, U21.5
unnamed: C137.1, H5.1
unnamed: D3.1, R26.2
unnamed: D3.2, Q62.3
unnamed: D6.1, Q2.3
unnamed: D6.2, R16.2
unnamed: D7.2, Q3.1, R15.2, R16.1
unnamed: D9.2, Q4.1, R24.2
unnamed: D12.2, Q5.1, R28.2
unnamed: D15.2, Q6.1, R32.2
unnamed: D16.1, R210.1
unnamed: D18.2, Q7.1, R36.2
unnamed: D20.1, R241.1
unnamed: D21.2, Q8.1, R40.2
unnamed: D24.2, Q9.1, R44.2
unnamed: D27.2, Q10.1, R48.2
unnamed: D28.2, J13.5, R187.1
unnamed: D28.3, J13.4, R188.1
unnamed: D30.2, Q11.1, R52.2
unnamed: D32.1, U6.43
unnamed: D33.2, Q12.1, R56.2
unnamed: D34.1, U11.43
unnamed: D36.2, Q13.1, R60.2
unnamed: D39.2, Q14.1, R64.2
unnamed: D42.2, Q15.1, R68.2
unnamed: D45.1, Q17.3
unnamed: D45.2, R76.2
unnamed: D46.2, Q18.1, R75.2, R76.1
unnamed: D48.2, Q19.1, R84.2
unnamed: D51.2, Q20.1, R88.2
unnamed: D54.2, Q21.1, R92.2
unnamed: D57.2, Q22.1, R96.2
unnamed: D60.2, Q23.1, R100.2
unnamed: D63.2, Q24.1, R104.2
unnamed: D66.2, Q25.1, R108.2
unnamed: D69.2, Q26.1, R112.2
unnamed: D72.2, Q27.1, R116.2
unnamed: D75.2, Q28.1, R120.2
unnamed: D78.2, Q29.1, R124.2
unnamed: D81.2, Q30.1, R128.2
unnamed: D84.1, R138.2
unnamed: L4.1, R9.2
unnamed: L5.1, R69.2
unnamed: Q2.1, R13.1
unnamed: Q3.3, R18.1
unnamed: Q4.3, R21.1
unnamed: Q5.3, R25.1
unnamed: Q6.3, R29.1
unnamed: Q7.3, R33.1
unnamed: Q8.3, R37.1
unnamed: Q9.3, R41.1
unnamed: Q10.3, R45.1
unnamed: Q11.3, R49.1
unnamed: Q12.3, R53.1
unnamed: Q13.3, R57.1
unnamed: Q14.3, R61.1
unnamed: Q15.3, R65.1
unnamed: Q17.1, R73.1
unnamed: Q18.3, R78.1
unnamed: Q19.3, R81.1
unnamed: Q20.3, R85.1
unnamed: Q21.3, R89.1
unnamed: Q22.3, R93.1
unnamed: Q23.3, R97.1
unnamed: Q24.3, R101.1
unnamed: Q25.3, R105.1
unnamed: Q26.3, R109.1
unnamed: Q27.3, R113.1
unnamed: Q28.3, R117.1
unnamed: Q29.3, R121.1
unnamed: Q30.3, R125.1
unnamed: Q31.3, R193.1
unnamed: Q32.2, R82.1
unnamed: Q32.5, Q32.6, R86.1
unnamed: Q33.2, R98.1
unnamed: Q34.1, R126.1
unnamed: Q37.3, R213.2
unnamed: Q39.3, Q39.6, Q41.1, R219.2
unnamed: Q40.2, R214.2
unnamed: Q40.5, R215.2
unnamed: Q42.1, R221.2
unnamed: Q43.1, R222.2
unnamed: Q44.5, Q44.6, R226.1
unnamed: Q45.1, R227.2
unnamed: Q46.1, R228.2
unnamed: Q47.1, R231.2
unnamed: Q48.1, R232.2
unnamed: Q49.1, R234.2
unnamed: Q50.1, R235.2
unnamed: Q51.3, Q51.6, Q53.1, R245.2
unnamed: Q52.2, R243.2
unnamed: Q52.5, R244.2
unnamed: Q54.5, Q54.6, R249.1
unnamed: Q55.4, R250.2
unnamed: Q56.4, R251.2
unnamed: Q58.4, R206.2, U16.3
unnamed: Q59.4, R94.2, U15.3
unnamed: Q60.2, R22.1
unnamed: Q61.3, R22.2
unnamed: Q63.2, R72.1
unnamed: Q64.2, R266.1
unnamed: Q65.2, R283.1
unnamed: Q66.2, R284.1
unnamed: Q67.2, R285.1
unnamed: Q68.2, R286.1
unnamed: R2.1, U1.7
unnamed: R5.2, R6.1, U4.12
unnamed: R7.2, TP1.1
unnamed: R10.1, U24.1
unnamed: R13.2, U6.36
unnamed: R42.1, R46.2
unnamed: R46.1, R90.2
unnamed: R73.2, U11.36
unnamed: R106.1, U14.3
unnamed: R110.1, U13.3
unnamed: R114.1, U14.2
unnamed: R118.1, U13.2
unnamed: R129.2, U7.8
unnamed: R130.2, U7.9
unnamed: R131.2, U7.4
unnamed: R132.2, U7.1
unnamed: R133.1, U8.4
unnamed: R135.1, U8.1
unnamed: R90.1, R193.2
unnamed: R196.1, R197.1, R198.2
unnamed: R199.1, R280.1, U9.3
unnamed: R200.1, R201.2, U9.4
unnamed: R202.1, U9.5
unnamed: R204.1, U15.1
unnamed: R205.1, U16.1
unnamed: R207.2, R239.1
unnamed: R58.2, R208.1
unnamed: R54.1, R208.2
unnamed: R210.2, R214.1
unnamed: R211.2, R215.1
unnamed: R212.2, R213.1
unnamed: R216.2, U18.2
unnamed: R217.2, U19.1
unnamed: R225.1, U18.5
unnamed: R4.2, R230.1
unnamed: R5.1, R230.2, U4.14
unnamed: R238.1, U20.1
unnamed: R240.2, R268.1
unnamed: R241.2, R243.1
unnamed: R242.2, R244.1
unnamed: R257.2, R258.1
unnamed: R259.2, R260.1
unnamed: R261.2, R262.1
unnamed: R262.2, R263.1
unnamed: R270.1, R271.2
unnamed: R271.1, R272.2
unnamed: R66.2, R274.2, U12.3
unnamed: R275.1, R276.2
unnamed: R276.1, R277.2
unnamed: R279.1, U12.1
unnamed: R282.1, U25.1
unnamed: U4.7, U4.10
PGEC: R187.2, U1.44
PGED: R188.2, U1.43
PRE_CHARGE_EN: R34.2, R126.2, U1.62
SHUNT_N: C141.1, J20.1, U24.4, U25.4
SHUNT_P: C142.1, J20.2, U24.3, U25.3
SPI_CKL: R283.2, U1.35, U6.41
SPI_CS: R72.2, U1.36, U6.44
SPI_MIPO: D32.2, R26.1, R30.1, U1.34
SPI_MOPI: R266.2, U1.33, U6.42
SW_EN: R82.2, R98.2, R267.2, R280.2, U1.32
Transducer_Input: J9.1, R197.2
Transducer_Input_AI: C99.1, R196.2, U1.12
Transducer_Pwr: C100.1, J9.3, L10.1
Transducer_Ref: C101.1, J9.2, U10.1, U10.4, U25.5
UART_RX: R118.2, U1.58
UART_RX_LV: R132.1, U13.7
UART_TX: R110.2, U1.59
UART_TX_LV: R131.1, U13.6
USB_5V: C61.1, C62.1, C63.1, D83.2, J14.1, U7.12
USB_D+: D89.3, J14.3, R129.1
USB_D-: D89.2, J14.2, R130.1
nRESET: D29.3, J13.1, R1.2, R2.2
