Voltworks-Garage/Hardware/PCBAs/DCDC/DCDC_01/DCDC_01.kicad_pcb

## KiCad design PCBAs/DCDC/DCDC_01/DCDC_01.kicad_pcb (2025-06-25)

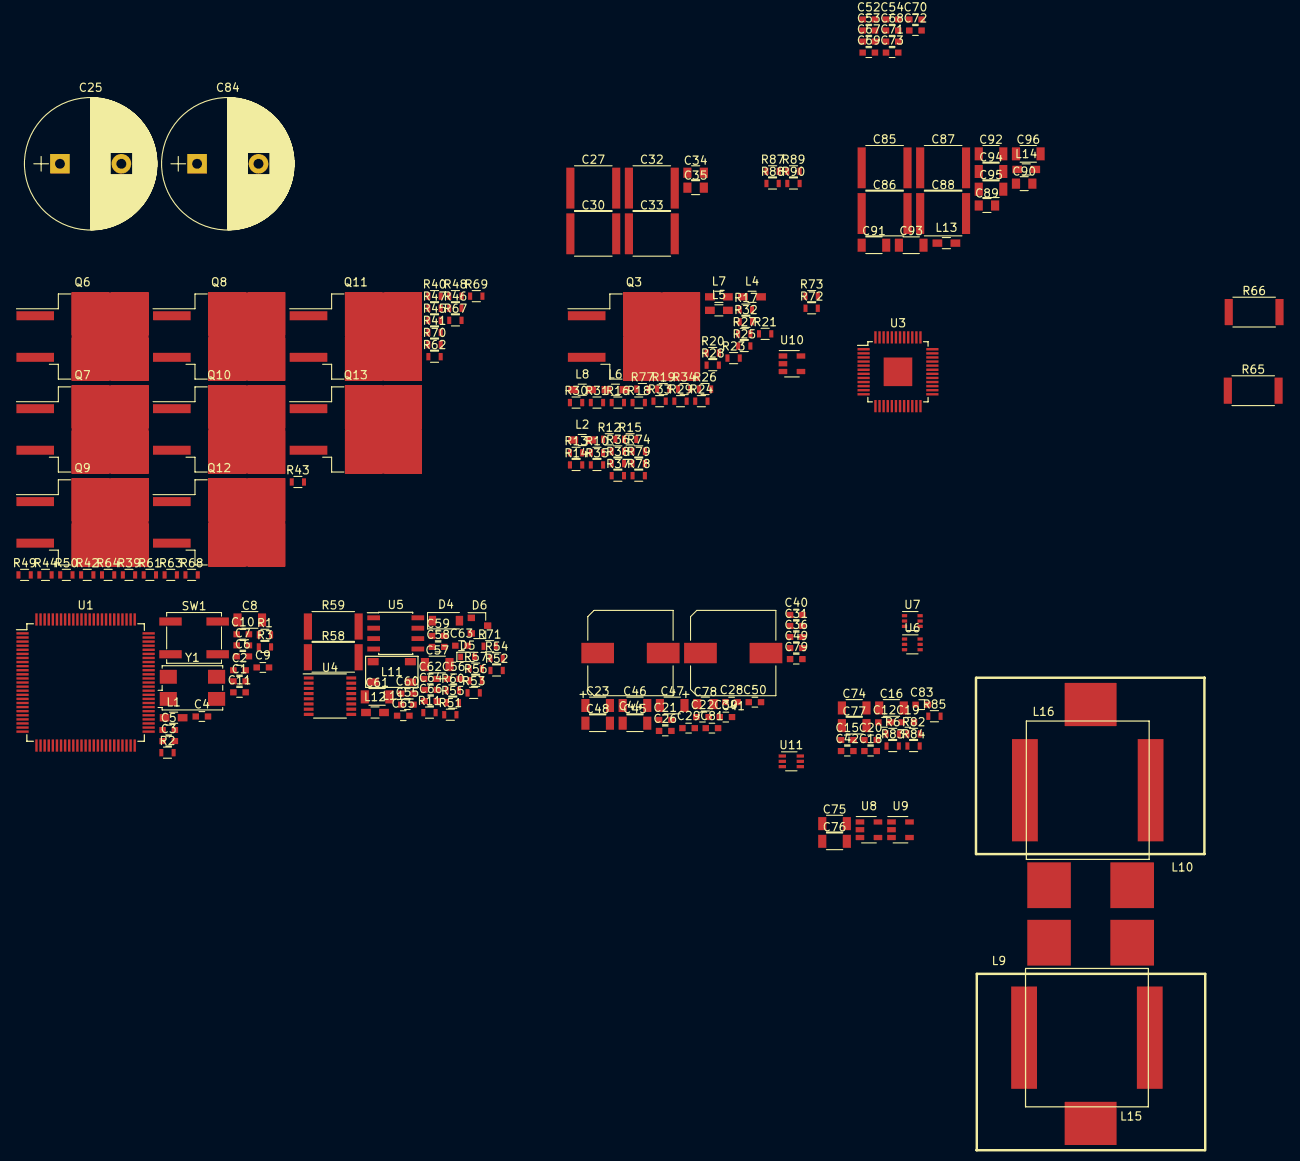
[picture p20: board DCDC_01.kicad_pcb from above]

Board: 2 copper layers, 204 parts (0 on the bottom side), 109 nets, no tracks yet.

Parts:
C1, C2, C3, C4, C5, C6, C7, C9, C18, C20, C21, C31, C42, C49, C53, C54, C55, C58, C79, C81, C83: 100nF; C_0603
C8, C16, C45, C46, C47, C48, C61, C74, C75, C76, C77, C91, C92, C93, C94, C95, C96: 10uF; C_1206
C10, C11, C62, C63, C64, C65: 18pF; C_0603
C12: 500nF; C_0603
C15: 330pF; C_0603
C19, C26, C50, C56, C59, C60, C66: 10nF; C_0603
C22, C29, C40, C68, C69, C70, C71, C72, C73: C; C_0603
C23: 4.7uF; C_1206
C25, C84: 100uF; CP_Radial_D16.0mm_P7.50mm
C27, C30, C32, C33, C85, C86, C87, C88: 1uF; C_2220
C28: 47pF; C_0603
C34, C89: 100nF; C_0805
C35, C90: 10nF; C_0805
C36, C39: 1nF; C_0603
C41, C44: 220uF; CP_Elec_10x10
C52, C67: 1uF; C_0603
C57: 4u7; C_1206
C78: 1uF; C_0805
D4: D_Schottky; D_SOD-123
D5: D_LED; D_0603
D6: D_Schottky_x2_ACom_AKK; D_SOT-23_ANK
L1, L2, L4, L5, L6, L7, L8, L12, L13, L14: Ferrite_Bead; L_0603_HandSoldering
L9, L10: L; PQ2614BLA-6R8K
L11: EMI_Filter_CommonMode; ACT45B
L15, L16: L; SRP1770TA-100M
Q3, Q6, Q7, Q8, Q9, Q10, Q11, Q12, Q13: Q_NMOS_GDS; TO-263-2
R1, R2, R14, R34, R36, R37, R47, R48, R78, R82, R85, R89, R90: 10k; R_0603
R3: 1M; R_0603
R6, R11, R15, R24, R38, R53, R54, R55, R56, R60, R72, R73, R74, R79: 100R; R_0603
R10, R49, R50, R61, R62, R63, R64, R67, R68, R69, R70: 3R3; R_0603
R12, R16, R33, R35, R83, R87: 100k; R_0603
R13, R84, R88: 47k; R_0603
R17, R18, R19, R20, R21, R25, R26, R27, R28, R29, R30, R31, R39, R40, R41, R42, R43, R44, R45, R46: 0R0; R_0603
R23: 3k83; R_0603
R32: 20R; R_0603
R51, R52: 22R; R_0603
R57, R71: 2k2; R_0603
R58, R59: 60R; R_2512
R65, R66: R; R_2512
R77: 22k; R_0603
SW1: PTS645SM43SMTR92 LFS; SW_SPST_EVQP0
U1: PIC33EPxxxMU810; TQFP-100_14x14mm_Pitch0.5mm
U3: LTC7810; TQFP-48-1EP_7x7mm_Pitch0.5mm
U4: FT230X; SSOP-16_3.9x4.9mm_Pitch0.635mm
U5: TCAN1051GVDRQ1; SOIC-8_3.9x4.9mm_Pitch1.27mm
U6, U7: INA21x; SOT-363_SC-70-6
U8, U9: TPS73633DBV; SOT-23-5
U10: OPA320-Q1; SOT-23-5
U11: TPL0401B-10-Q1; Texas_R-PDSO-G6
Y1: 8MHz; Crystal_SMD_7050-4pin_7.0x5.0mm

Connections:
5V_MONITOR_AI: C20.1, R36.2, R37.1, U1.41
12V_MONITOR_AI: C42.1, R89.1, U1.34
+3.3VA: C7.1, L1.1, U1.30
+3.3VP: C77.1, C78.2, C81.2, U9.5, U10.5, U11.1, U11.6
+3V3: C1.1, C2.1, C3.1, C4.1, C5.1, C6.1, C9.1, C59.1, C76.1, L1.2, R1.1, R57.1, R71.1, U1.2, U1.16, U1.37, U1.46, U1.55, U1.62, U1.86, U5.5, U8.5
+5V: C16.1, C18.1, C19.1, C60.1, C61.1, C74.1, C75.1, D4.1, R35.1, U5.3, U8.1, U8.3, U9.1
+12P: C52.1, C67.1, R13.1, U6.3, U7.3
+12V: C41.1, C44.1, C45.1, C46.1, C47.1, C48.1, C49.1, C50.1, C91.1, C92.1, C93.1, C94.1, C95.1, C96.1, L7.1, R12.1, R32.1, R65.1, R66.1
+BATT: L2.2, L4.2, L5.2, L6.1, L8.2, L13.2, L14.2, R82.1
/Top_Level/Communication/CAN_FILT_N: C63.1, L11.3, U5.6
/Top_Level/Communication/CAN_FILT_P: C62.2, L11.1, U5.7
/Top_Level/Communication/USB_VCCio: C55.1, U4.3, U4.10, U4.11
/Top_Level/DCDC_Controller/12V_ULVO_HV: R21.1, U3.32
/Top_Level/DCDC_Controller/Bgate_P1: R20.1, U3.37
/Top_Level/DCDC_Controller/Bgate_P2: R27.2, U3.24
/Top_Level/DCDC_Controller/EXTVcc: C31.1, L7.2, U3.11
/Top_Level/DCDC_Controller/FeedBack: C40.2, R33.2, R34.1, R77.2, U3.47
/Top_Level/DCDC_Controller/INTVcc: C21.1, R18.1, R28.1, R31.1, U3.3, U3.14, U3.29
/Top_Level/DCDC_Controller/NDRV: R24.2, R29.2, U3.10
/Top_Level/DCDC_Controller/Tgate_P1: R19.1, U3.42
/Top_Level/DCDC_Controller/Tgate_P2: R26.2, U3.19
/Top_Level/DCDC_Controller/VBATT_FILT_NDRV_HV: L8.1, Q3.2
/Top_Level/DCDC_Controller/Vin_HV: L6.2, U3.35
/Top_Level/DCDC_Power_Stage/Isense_P1_N: C70.2, R67.2, U6.5
/Top_Level/DCDC_Power_Stage/Isense_P1_P: C70.1, R61.1, U6.4
/Top_Level/DCDC_Power_Stage/Isense_P2_N: C72.2, R69.2, U7.5
/Top_Level/DCDC_Power_Stage/Isense_P2_P: C72.1, R63.1, U7.4
/Top_Level/PowerRails/5V_SNUB_HV: C15.2, R10.1
/Top_Level/PowerRails/+BATT_SW_GATE_HV: R82.2, R83.1
Bgate_P1_Res: R20.2, R40.2, R44.2
Bgate_P2_Res: R27.1, R42.2, R46.2
CAN_N: C65.1, D6.2, L11.4, R59.1
CAN_P: C64.2, D6.3, L11.2, R58.2
CAN_RX: R55.1, U1.11
CAN_SLEEP: R56.1, U1.3
CAN_TX: R54.1, U1.10
DEBUG_LED: D5.2, U1.17
DRVcc: C23.1, Q3.3, R29.1, U3.26
GND: C1.2, C2.2, C3.2, C4.2, C5.2, C6.2, C7.2, C8.2, C9.2, C10.2, C11.2, C12.2, C16.2, C18.2, C19.2, C20.2, C21.2, C22.2, C23.2, C25.2, C26.1, C27.2, C28.2, C29.2, C30.2, C31.2, C32.2, C33.2, C34.2, C35.2, C36.2, C39.2, C41.2, C42.2, C44.2, C45.2, C46.2, C47.2, C48.2, C49.2, C50.2, C52.2, C53.1, C54.1, C55.2, C56.2, C57.2, C58.2, C59.2, C60.2, C61.2, C62.1, C63.2, C64.1, C65.2, C66.2, C67.2, C74.2, C75.2, C76.2, C77.2, C78.1, C79.1, C81.1, C83.2, C84.2, C85.2, C86.2, C87.2, C88.2, C89.2, C90.2, C91.2, C92.2, C93.2, C94.2, C95.2, C96.2, D6.1, Q7.3, Q9.3, Q11.3, Q13.3, R10.2, R14.2, R16.2, R17.2, R25.2, R30.2, R34.2, R37.2, R49.2, R50.2, R60.1, R85.2, SW1.1, U1.15, U1.31, U1.36, U1.45, U1.65, U1.75, U3.5, U3.25, U3.49, U4.5, U4.13, U5.2, U6.1, U6.2, U7.1, U7.2, U8.2, U9.2, U10.2, U11.2, Y1.2, Y1.4
I2C_SCL: R57.2, U1.50, U11.3
I2C_SDA: R71.2, U1.49, U11.4
unnamed: C8.1, U1.85
unnamed: C10.1, R3.1, U1.64, Y1.1
unnamed: C11.1, R3.2, U1.63, Y1.3
unnamed: C22.1, R16.1, U3.7
unnamed: C26.2, R23.2
unnamed: C28.1, R23.1, U3.46
unnamed: C29.1, U3.45
unnamed: C36.1, U3.16
unnamed: Q3.1, R24.1
unnamed: C39.1, U3.15
unnamed: C40.1, R32.2, R33.1
unnamed: C57.1, C58.1, D4.2, L12.1, U4.12
unnamed: C66.1, R58.1, R59.2
unnamed: C68.2, R49.1
unnamed: C69.2, R50.1
unnamed: C79.2, U10.3, U11.5
unnamed: D5.1, R60.2
unnamed: R85.1, R88.2, R90.2
unnamed: L10.2, L16.1, R66.2
unnamed: L9.2, L15.1, R65.2
unnamed: R12.2, R78.1
unnamed: Q6.1, R39.1
unnamed: Q7.1, R40.1
unnamed: Q8.1, R41.1
unnamed: Q9.1, R42.1
unnamed: Q10.1, R43.1
unnamed: Q11.1, R44.1
unnamed: Q12.1, R45.1
unnamed: Q13.1, R46.1
unnamed: R2.1, U1.13
unnamed: R11.1, U4.4
unnamed: R13.2, R14.1, R89.2
unnamed: R17.1, R18.2, U3.4
unnamed: R25.1, R28.2, U3.8
unnamed: R30.1, R31.2, U3.2
unnamed: R47.2, U6.6
unnamed: R48.2, U7.6
unnamed: R51.2, U4.8
unnamed: R52.2, U4.9
unnamed: R53.1, U4.1
unnamed: R54.2, U5.1
unnamed: R55.2, U5.4
unnamed: R56.2, U5.8
unnamed: R74.2, U9.3
unnamed: R77.1, U10.1, U10.4
unnamed: R83.2, R87.1
unnamed: R84.2, R88.1
PGEC: R72.2, U1.74
PGED: R73.2, U1.73
Phase1_Isense_AI: C53.2, R47.1, U1.32
Phase2_Isense_AI: C54.2, R48.1, U1.33
RUN_LTC: R21.2, U1.98
SW_EN: R6.1, R15.1, R38.1, R74.1, U1.93
SW_Node_P1: C68.1, L9.1, L15.2, Q6.3, Q7.2, Q10.3, Q11.2, U3.41
SW_Node_P2: C69.1, L10.1, L16.2, Q8.3, Q9.2, Q12.3, Q13.2, U3.20
Sense_P1_N: C71.2, R68.2, U3.1
Sense_P1_P: C71.1, R62.2, U3.48
Sense_P2_N: C73.2, R70.2, U3.12
Sense_P2_P: C73.1, R64.2, U3.13
Tgate_P1_Res: R19.2, R39.2, R43.2
Tgate_P2_Res: R26.1, R41.2, R45.2
UART_RX: R53.2, U1.14
UART_TX: R11.2, U1.12
USB_5V: C56.1, L12.2
VBATT_FILT_PHASE_1_HV: C84.1, C85.1, C86.1, C87.1, C88.1, C89.1, C90.1, L13.1, L14.1, Q6.2, Q10.2
VBATT_FILT_PHASE_2_HV: C25.1, C27.1, C30.1, C32.1, C33.1, C34.1, C35.1, L4.1, L5.1, Q8.2, Q12.2
VBATT_MONITOR_AI: C83.1, R90.1, U1.35
nRESET: R1.2, R2.2, SW1.2
